francescodelucia/BabyCarCANBUS/Componenti_Codice_PCB/ControlloPWM_Motori/Senzanome.png

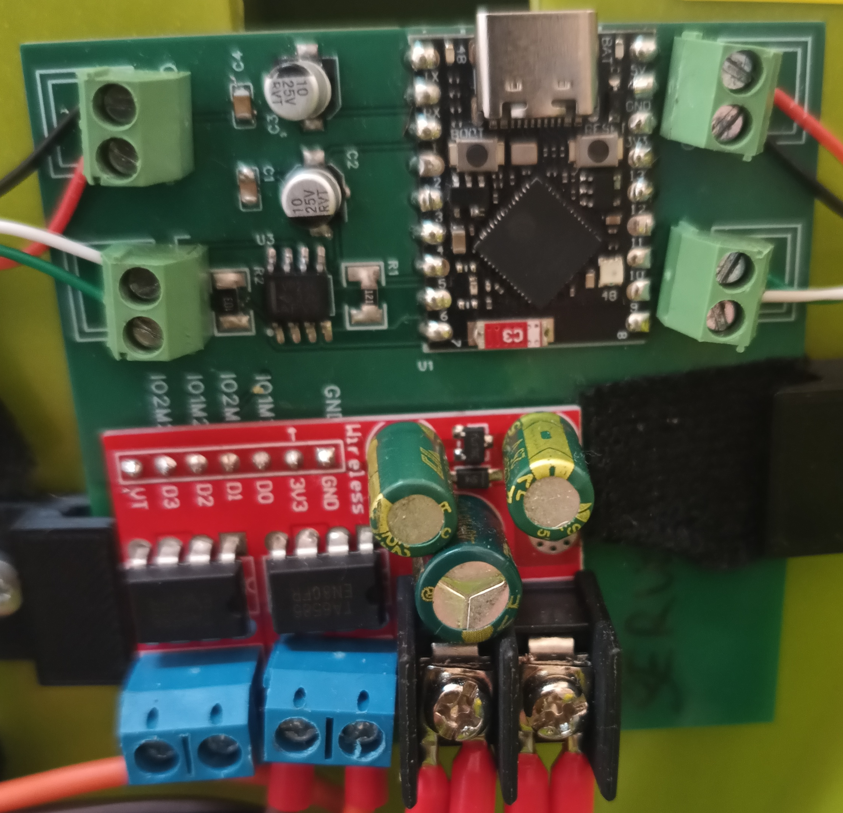
Componenti_Codice_PCB/ControlloPWM_Motori/Senzanome.png
