francescodelucia/BabyCarCANBUS/Componenti_Codice_PCB/ECU_dashboard_integrato/code/ECU_dashboard_integrato/imgs/dash_main.bmp

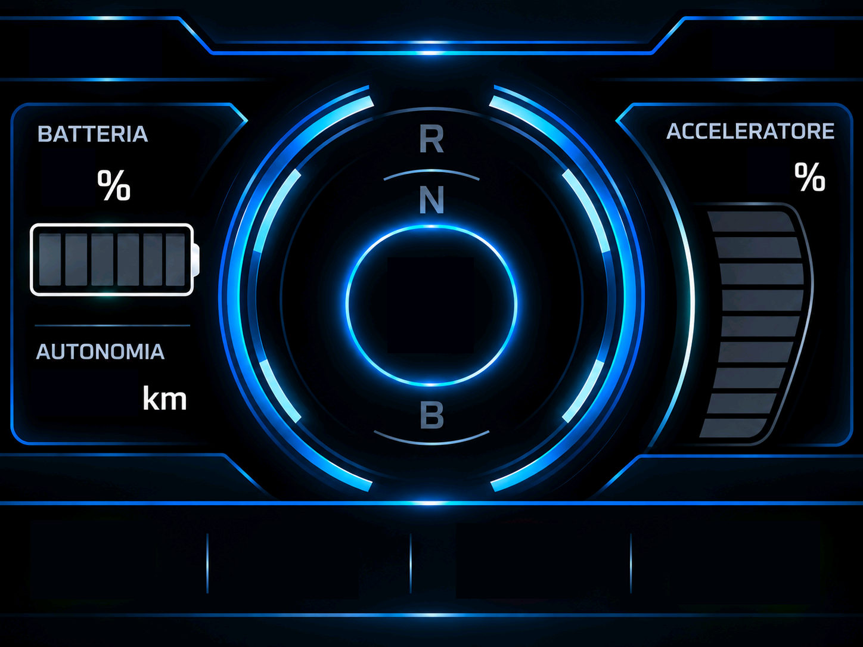
Componenti_Codice_PCB/ECU_dashboard_integrato/code/ECU_dashboard_integrato/imgs/dash_main.bmp
