francescodelucia/BabyCarCANBUS/Componenti_Codice_PCB/ECU_dashboard_integrato/code/ECU_dashboard_integrato/imgs/spia_carica.bmp

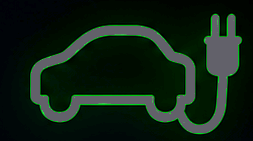
Componenti_Codice_PCB/ECU_dashboard_integrato/code/ECU_dashboard_integrato/imgs/spia_carica.bmp
