francescodelucia/BabyCarCANBUS/Componenti_Codice_PCB/ECU_dashboard_integrato/display.jpg

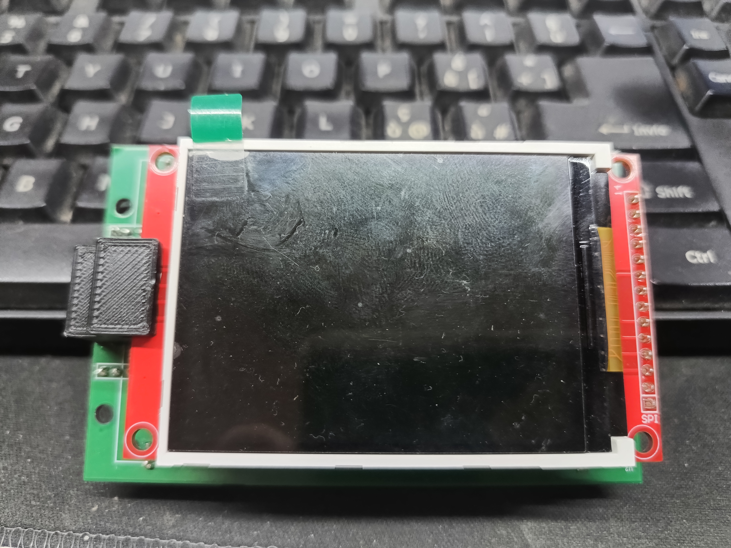
Componenti_Codice_PCB/ECU_dashboard_integrato/display.jpg
