francescodelucia/BabyCarCANBUS/Componenti_Codice_PCB/ECU_dashboard_integrato/display_on.jpg

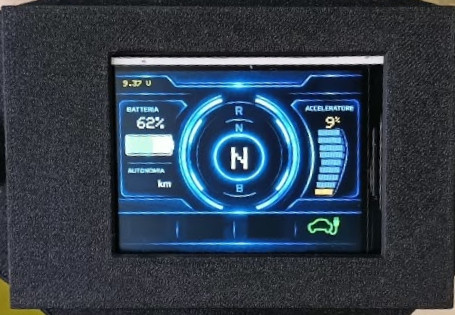
Componenti_Codice_PCB/ECU_dashboard_integrato/display_on.jpg
