francescodelucia/BabyCarCANBUS/Componenti_Codice_PCB/ECU_dashboard_integrato/pcb_button.png

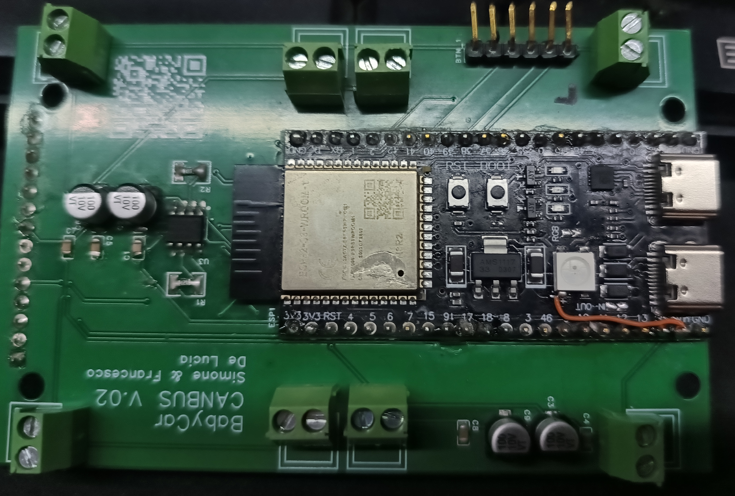
Componenti_Codice_PCB/ECU_dashboard_integrato/pcb_button.png
