francescodelucia/BabyCarCANBUS/Componenti_Codice_PCB/ECU_dashboard_integrato/pcb_top.jpg

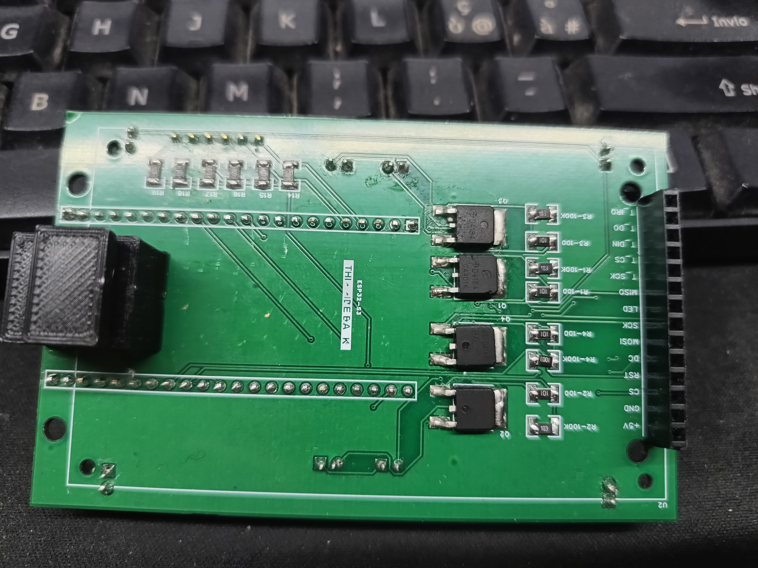
Componenti_Codice_PCB/ECU_dashboard_integrato/pcb_top.jpg
