francescodelucia/BabyCarCANBUS/Componenti_Codice_PCB/Sensore_Lidar/Senzanome.png

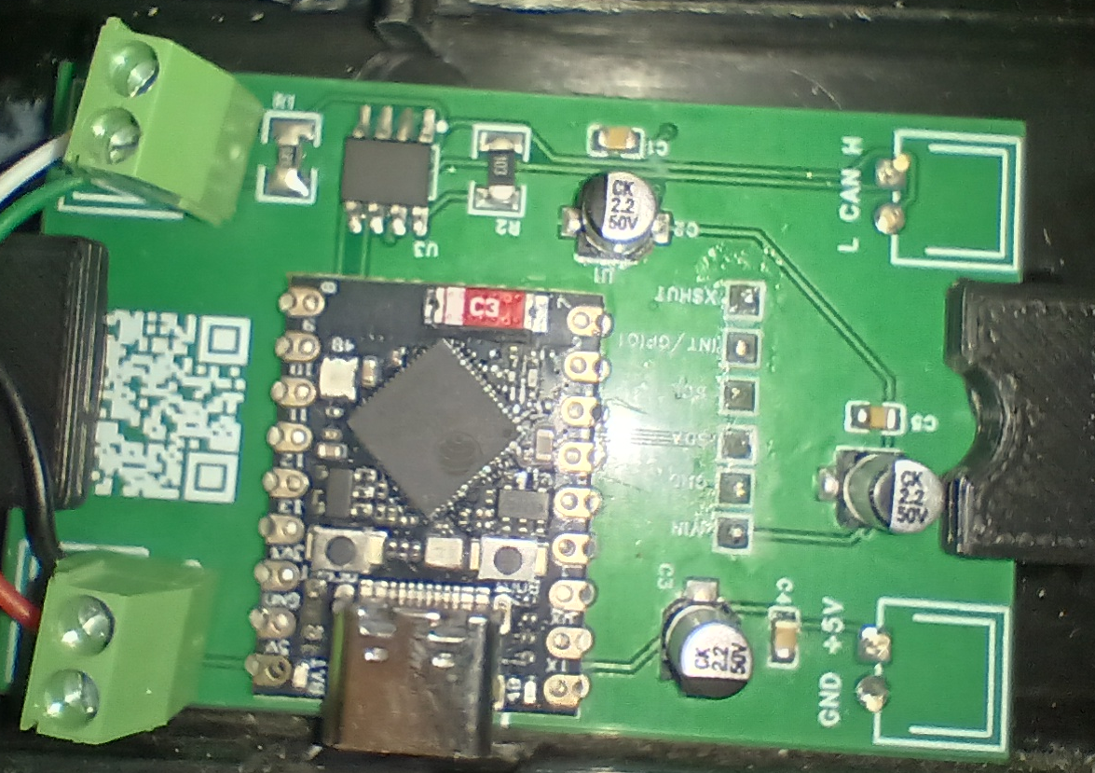
Componenti_Codice_PCB/Sensore_Lidar/Senzanome.png
