francescodelucia/BabyCarCANBUS/pcbs/Anti_Colision_Lidar/3D_BabyCar_CANBUS_Lidar.png

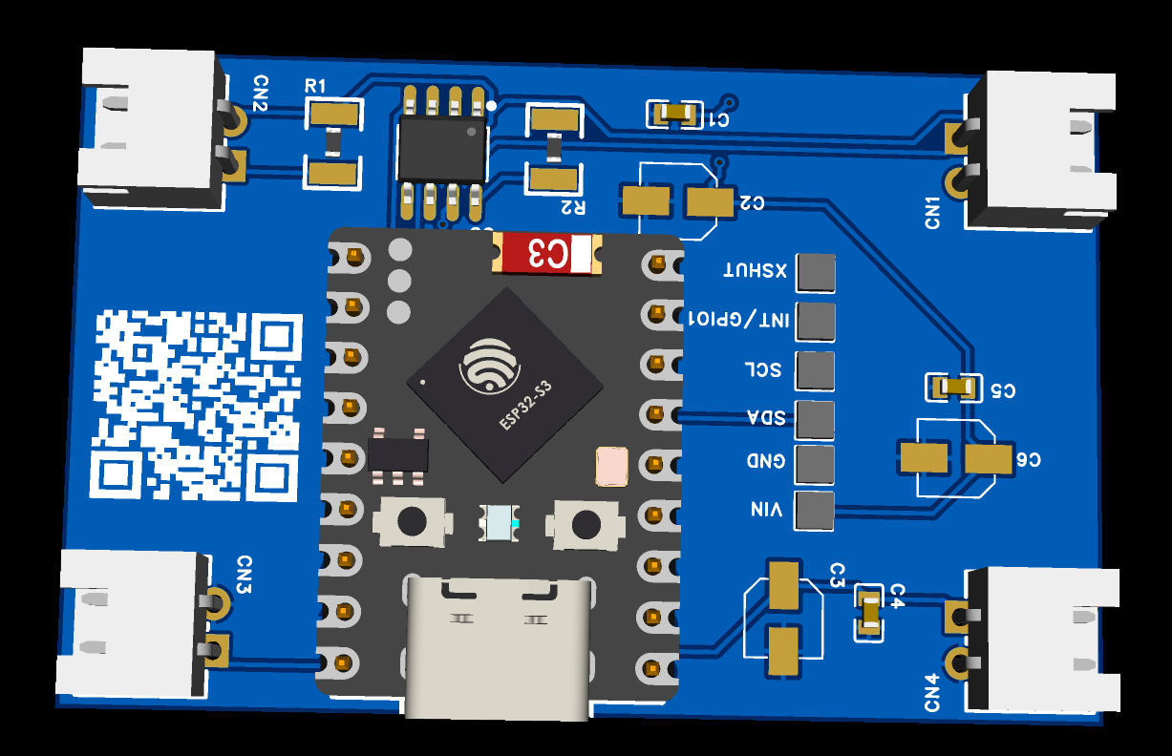
pcbs/Anti_Colision_Lidar/3D_BabyCar_CANBUS_Lidar.png
