francescodelucia/BabyCarCANBUS/pcbs/Anti_Colision_Lidar/PCB_BabyCAR_CANBUS_Lidar.png

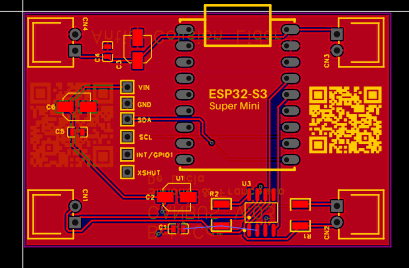
pcbs/Anti_Colision_Lidar/PCB_BabyCAR_CANBUS_Lidar.png
