francescodelucia/BabyCarCANBUS/pcbs/ECU_display_data_info/3d.png

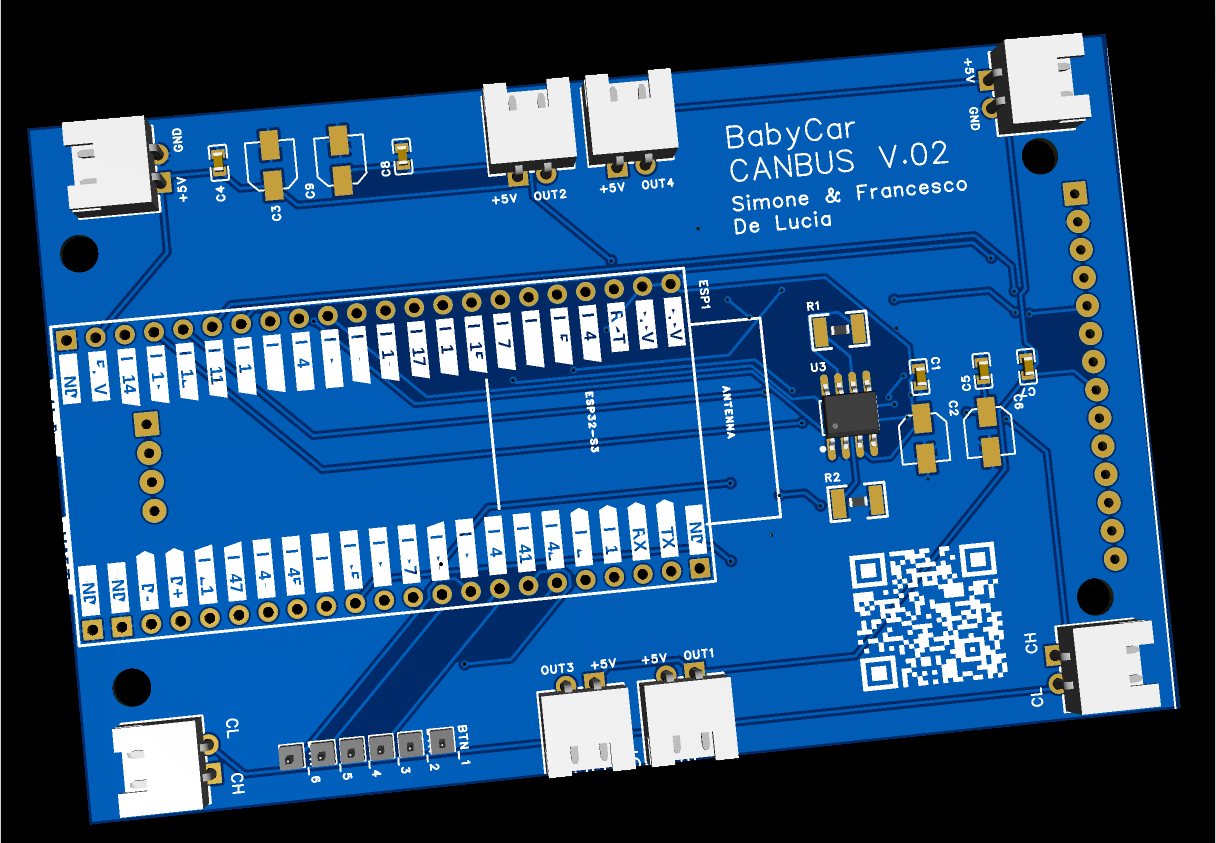
pcbs/ECU_display_data_info/3d.png
