francescodelucia/BabyCarCANBUS/pcbs/ECU_display_data_info/back_pcb.png

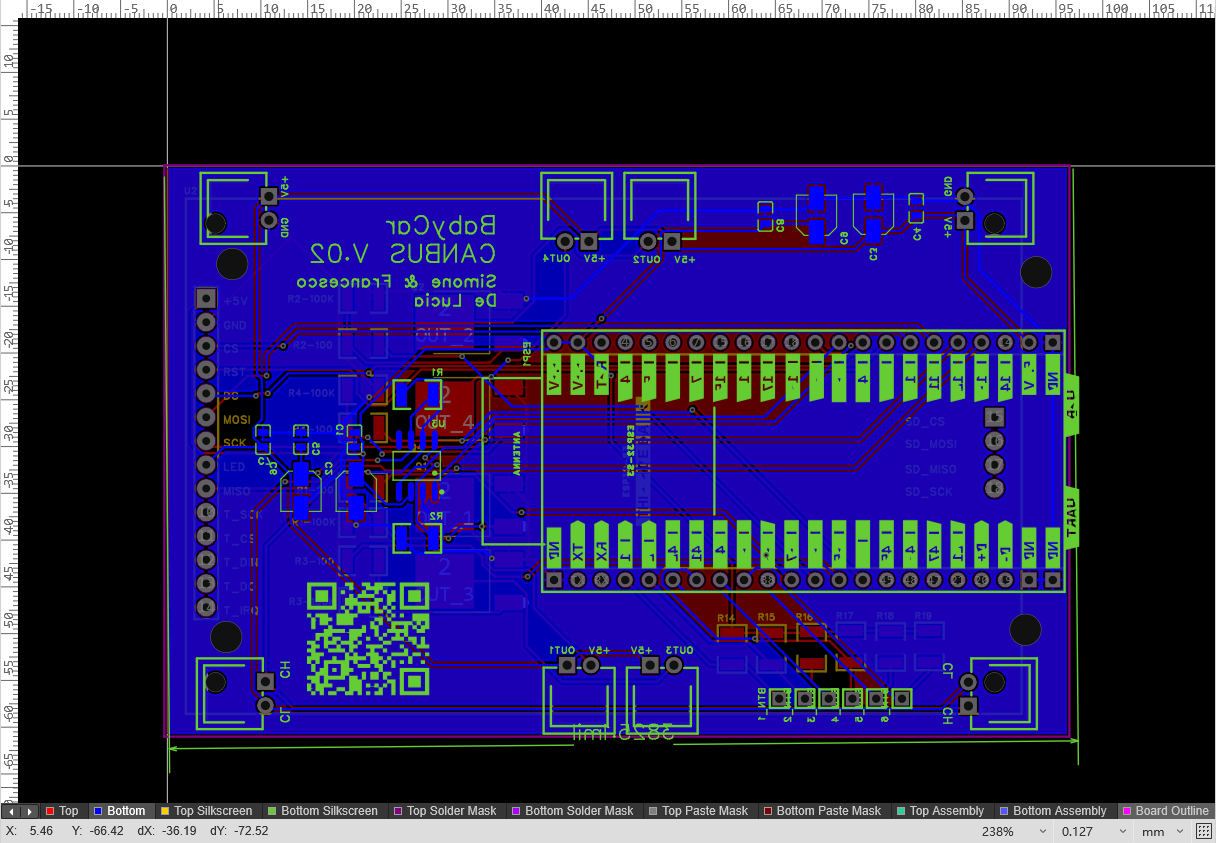
pcbs/ECU_display_data_info/back_pcb.png
