francescodelucia/BabyCarCANBUS/pcbs/ECU_display_data_info/front_pcb.png

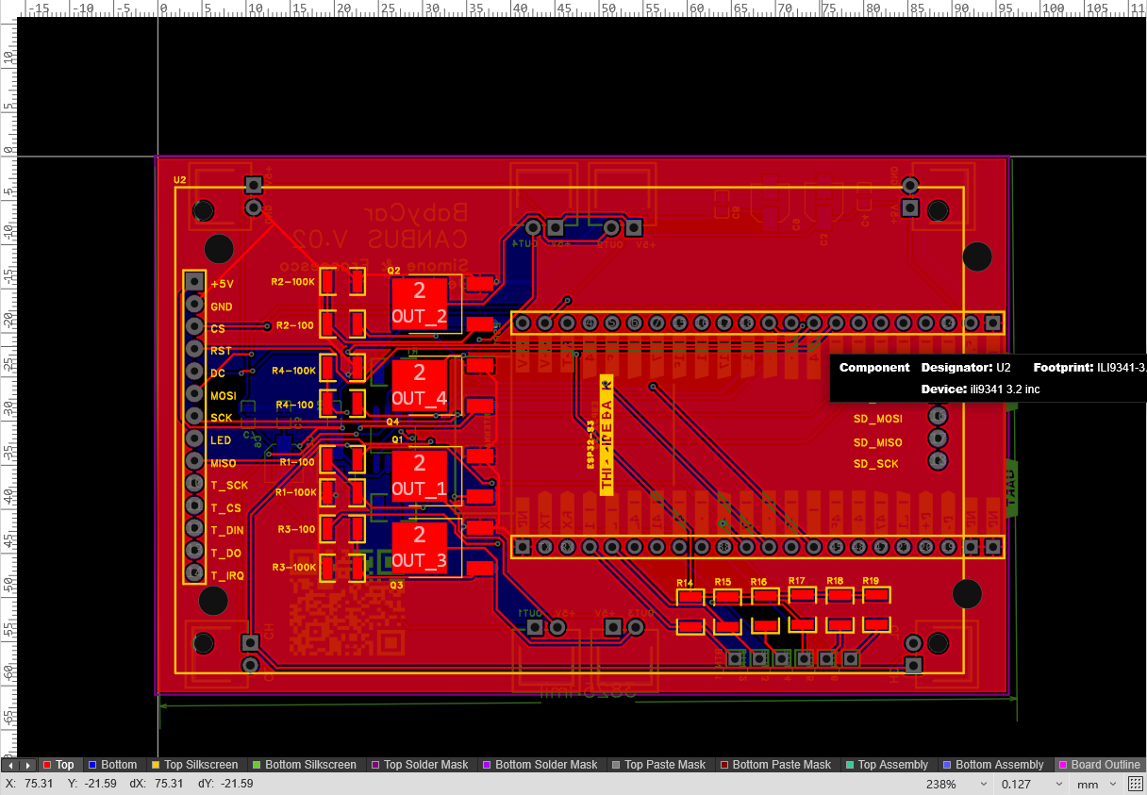
pcbs/ECU_display_data_info/front_pcb.png
