francescodelucia/BabyCarCANBUS/pcbs/Light_Battery_Control/scheda_contollo_accelleratore_3D.png

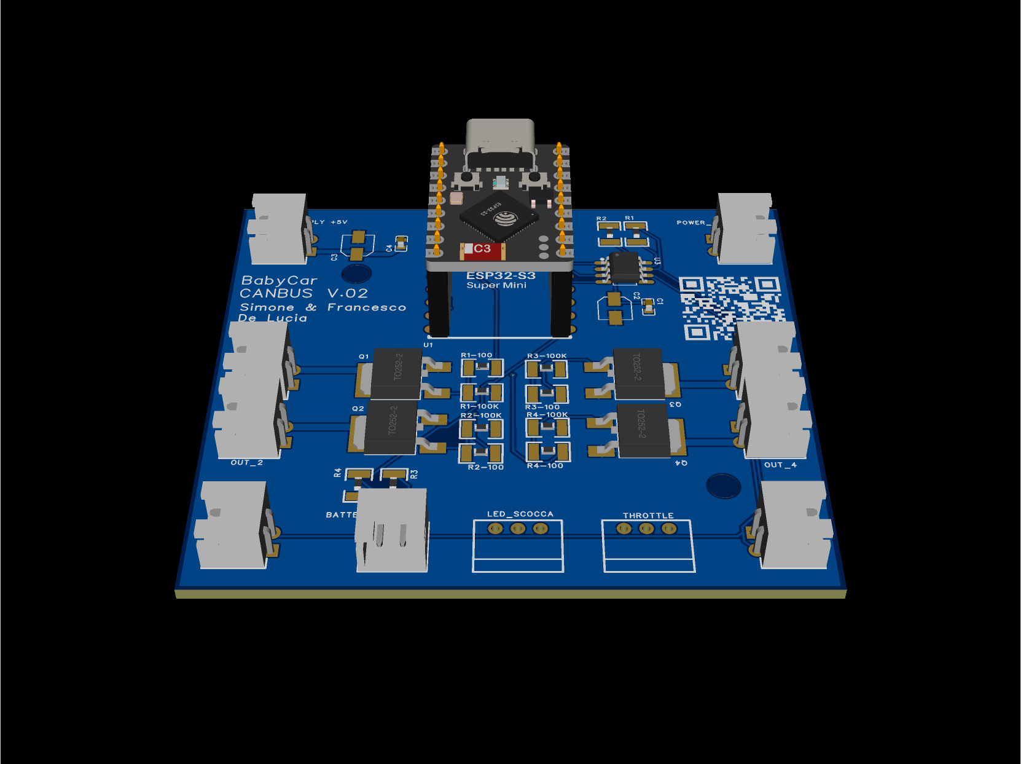
pcbs/Light_Battery_Control/scheda_contollo_accelleratore_3D.png
