francescodelucia/BabyCarCANBUS/pcbs/Light_Battery_Control/scheda_contollo_accelleratore_pcb.png

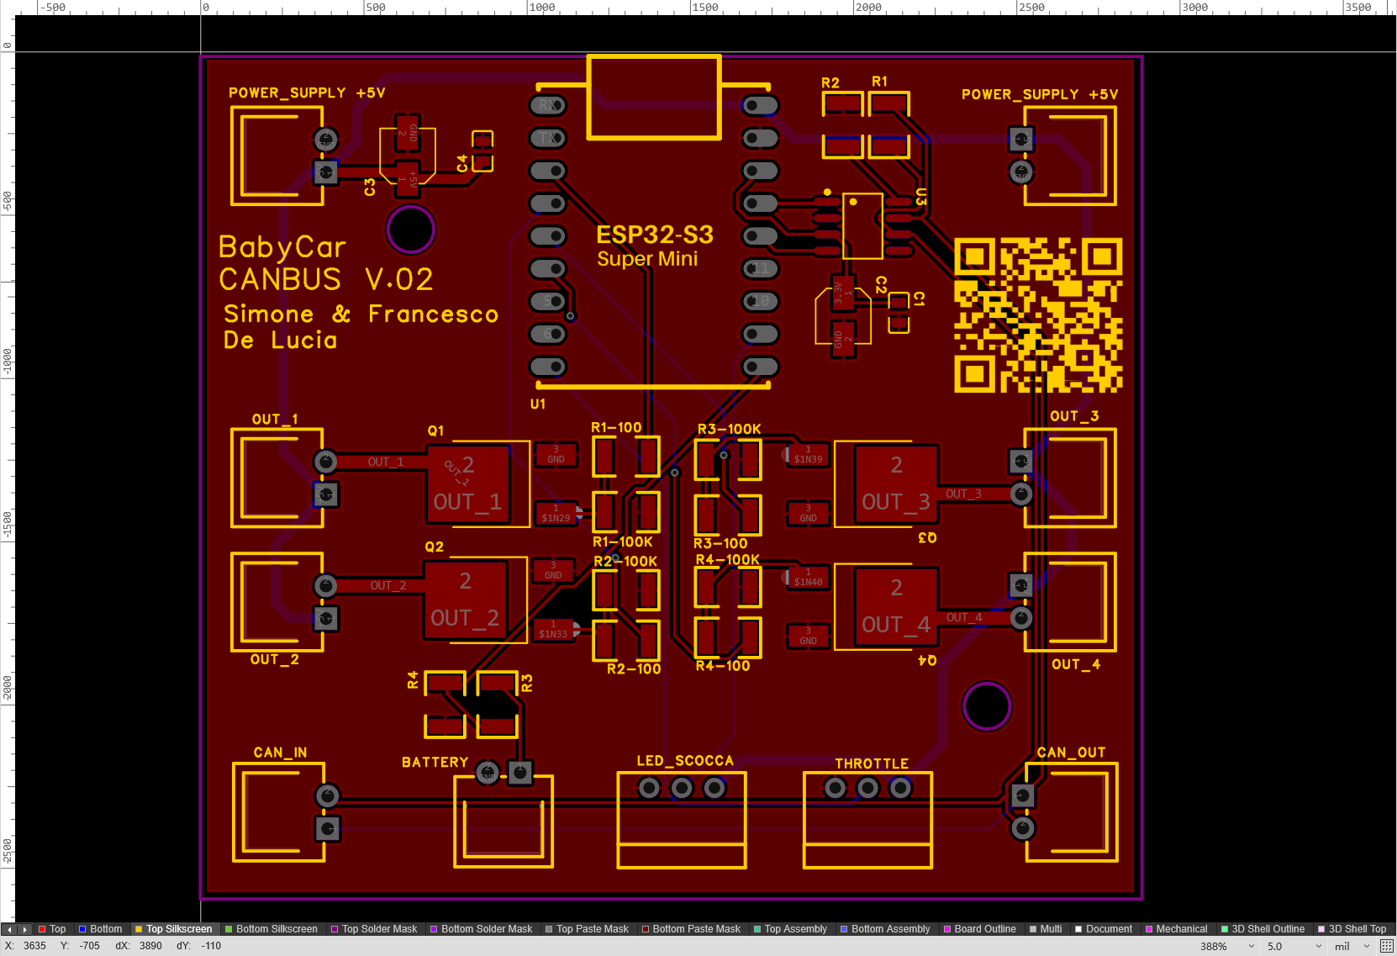
pcbs/Light_Battery_Control/scheda_contollo_accelleratore_pcb.png
