francescodelucia/BabyCarCANBUS/pcbs/Light_Battery_Control/scheda_contollo_accelleratore_schemaelettrico.png

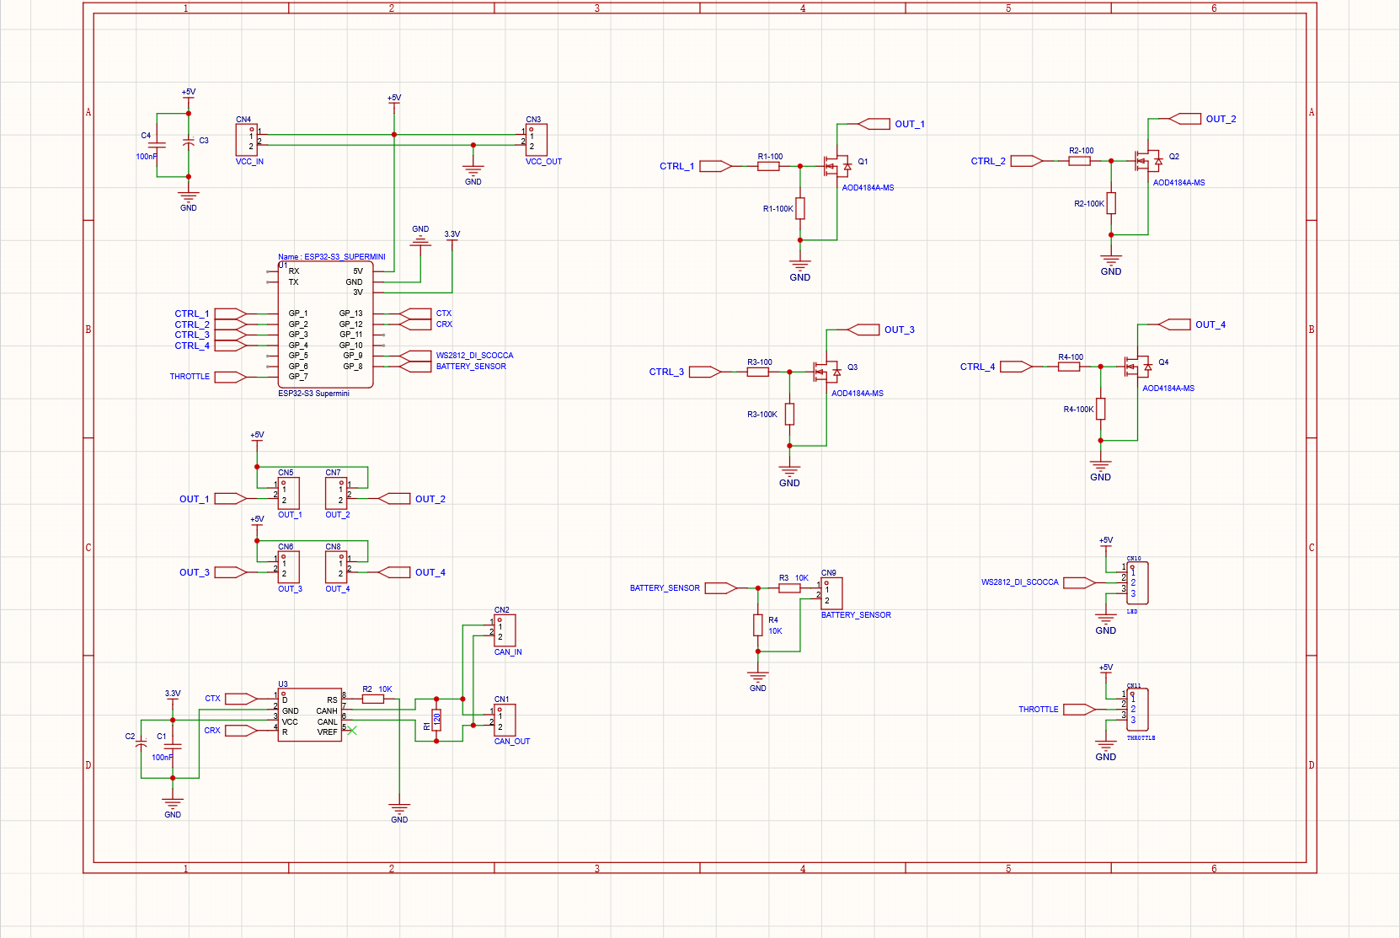
pcbs/Light_Battery_Control/scheda_contollo_accelleratore_schemaelettrico.png
