francescodelucia/BabyCarCANBUS/V1_images/2jpeg.jpeg

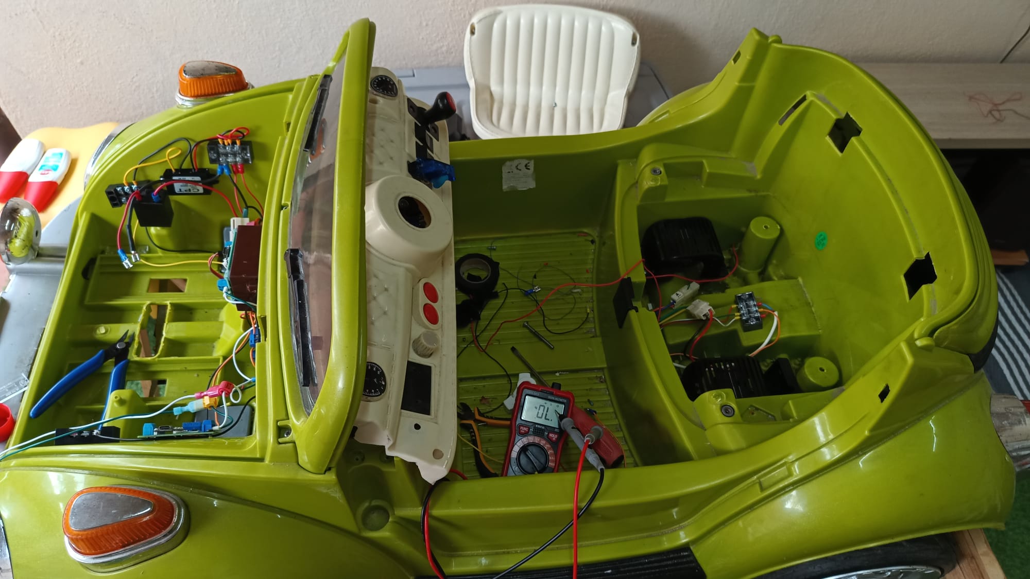
V1_images/2jpeg.jpeg
