francescodelucia/BabyCarCANBUS/V1_images/4.jpeg

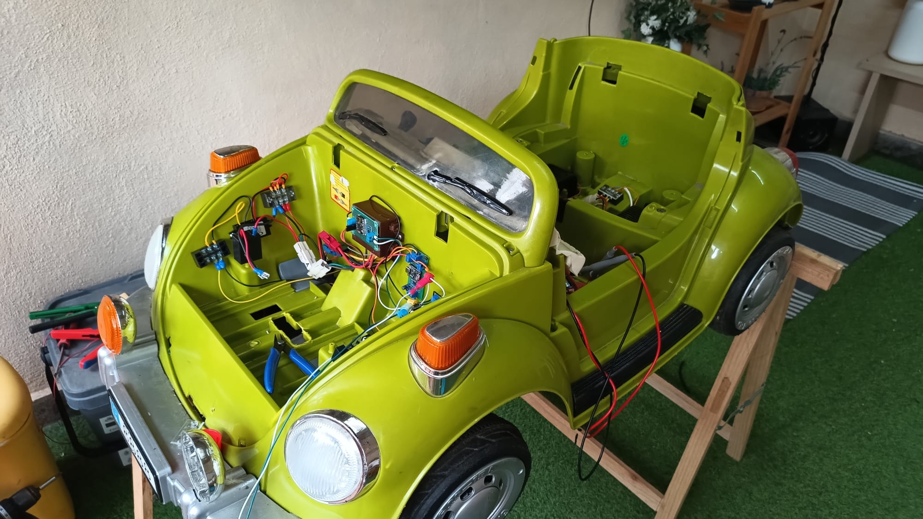
V1_images/4.jpeg
