francescodelucia/BabyCarCANBUS/V1_images/5.jpeg

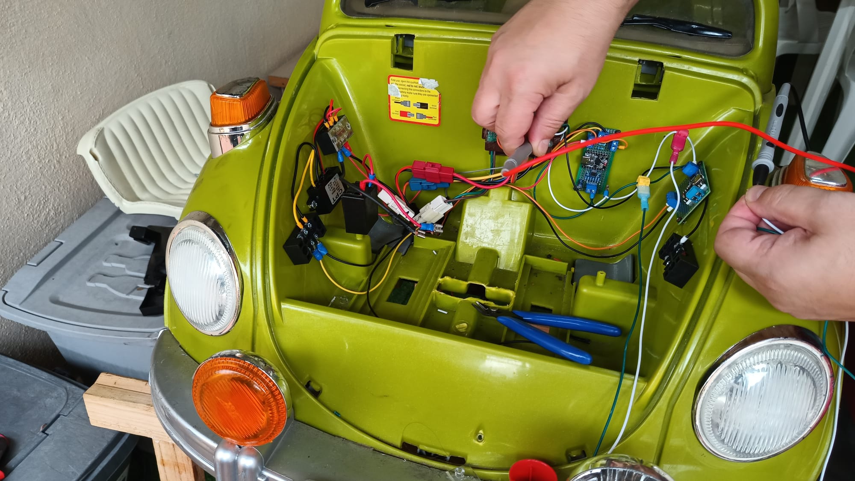
V1_images/5.jpeg
