francescodelucia/BabyCarCANBUS/V1_images/6.jpeg

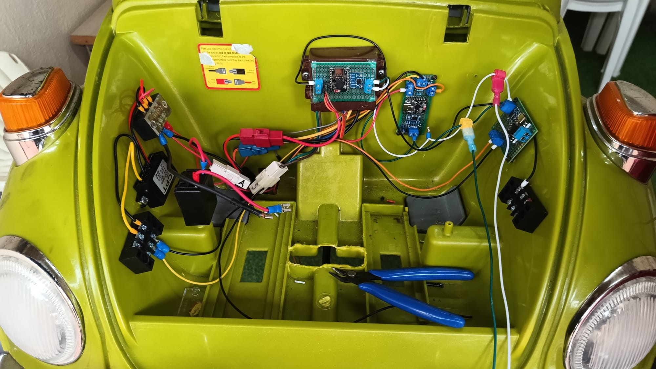
V1_images/6.jpeg
