francescodelucia/BabyCarCANBUS/V1_images/10.jpeg

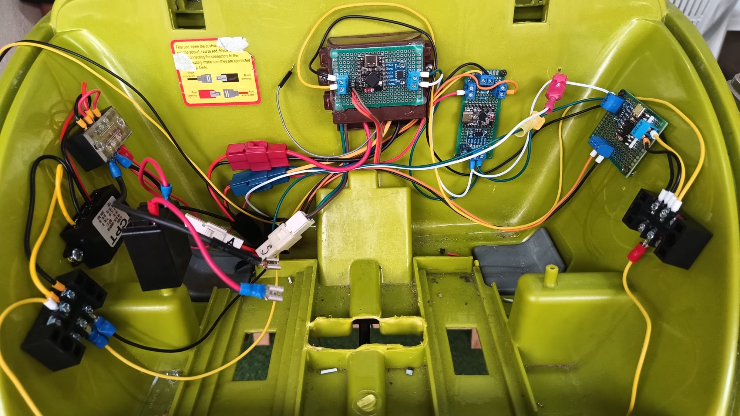
V1_images/10.jpeg
