francescodelucia/BabyCarCANBUS/V1_images/11.jpeg

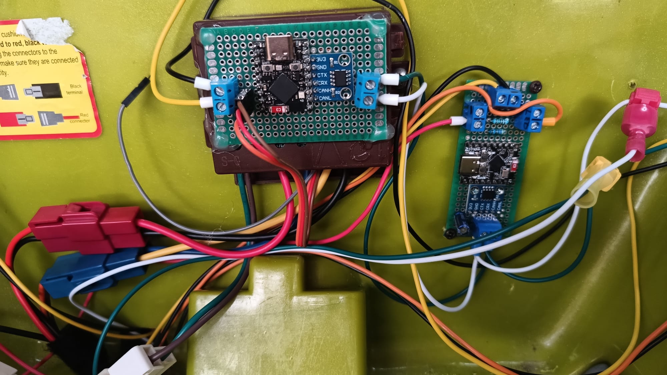
V1_images/11.jpeg
