francescodelucia/BabyCarCANBUS/V1_images/12.jpeg

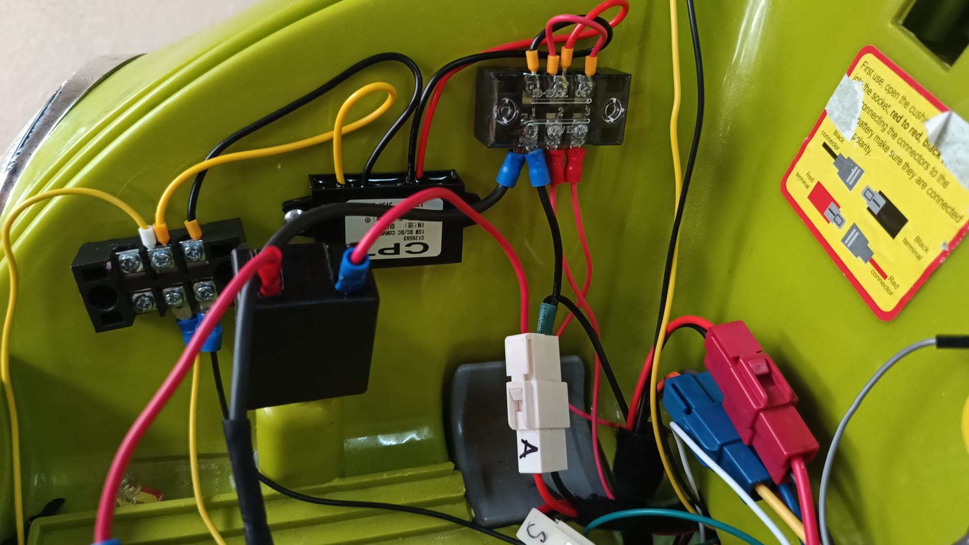
V1_images/12.jpeg
