francescodelucia/BabyCarCANBUS/V1_images/17.jpeg

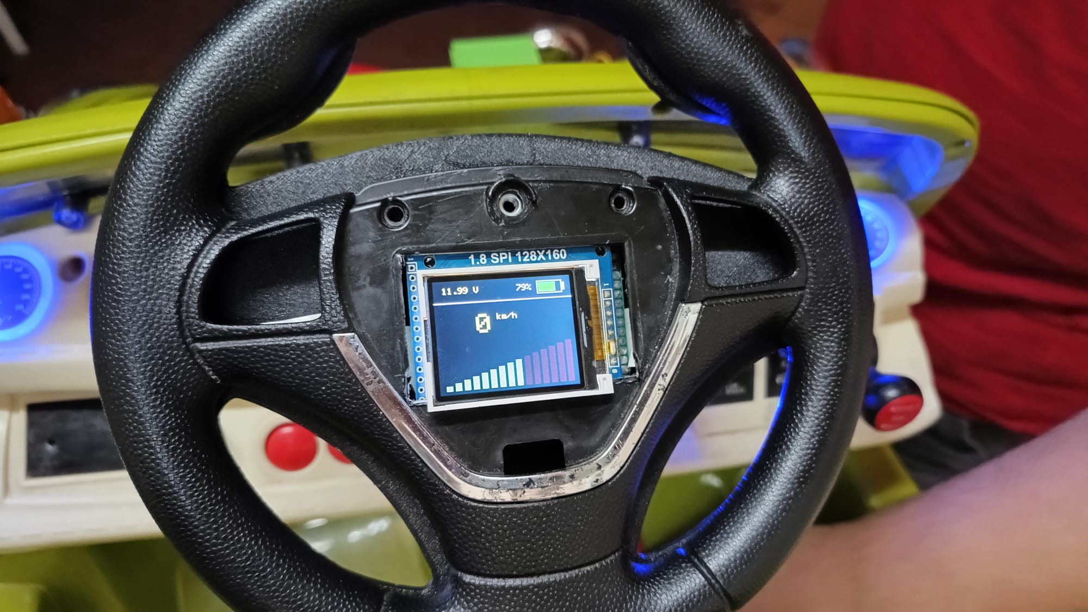
V1_images/17.jpeg
