francescodelucia/BabyCarCANBUS/V1_images/18.jpeg

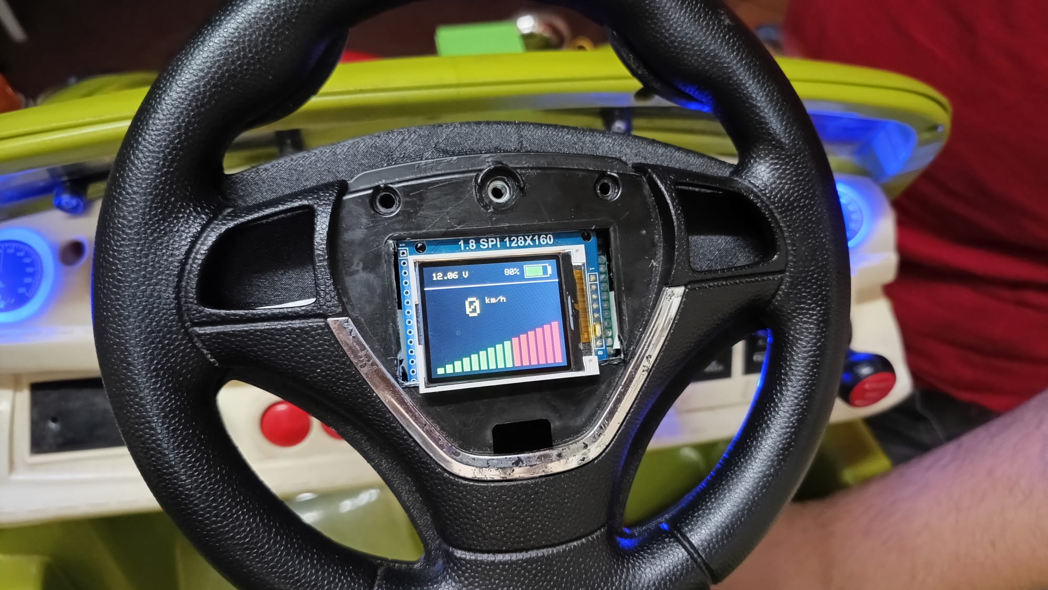
V1_images/18.jpeg
