francescodelucia/BabyCarCANBUS/V1_images/21.jpeg

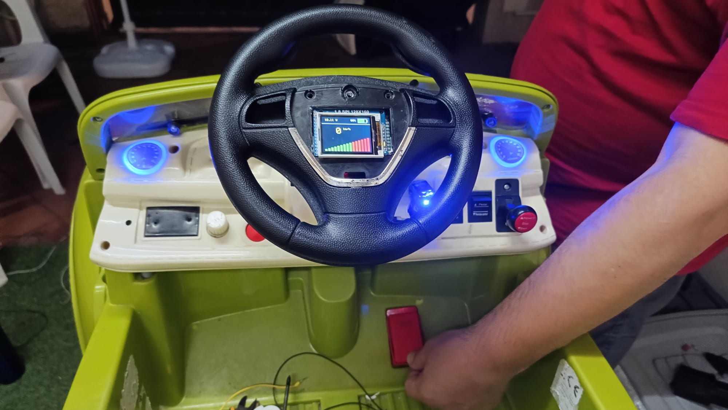
V1_images/21.jpeg
