francescodelucia/BabyCarCANBUS/3d/EncoderManubrio.FCStd

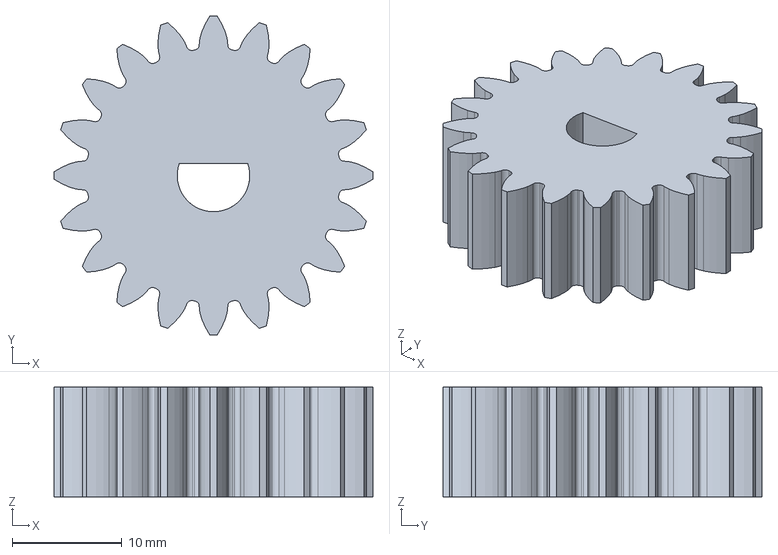
[picture p31: CAD file, 2026-10-26]
3d/EncoderManubrio.FCStd
29.0 x 29.0 x 10.0 mm
