francescodelucia/BabyCarCANBUS/3d/Supporti_per_schede.FCStd

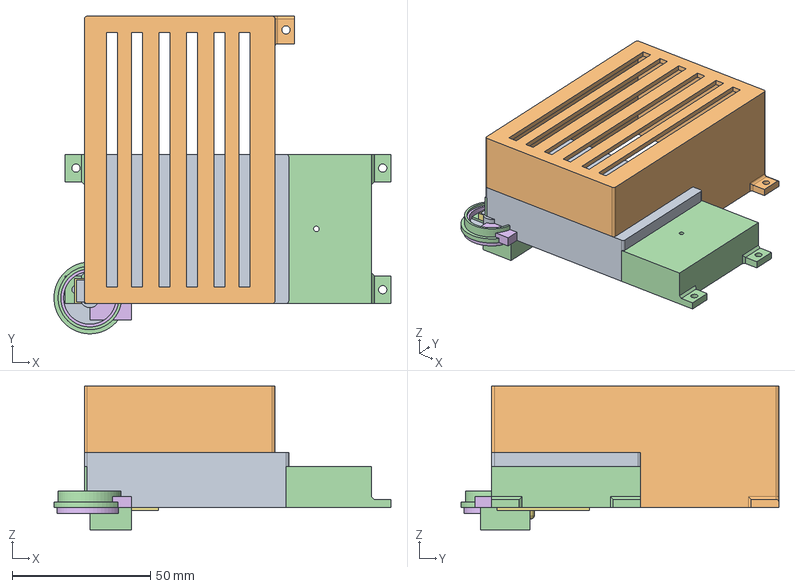
[picture p32: CAD file, 2026-10-26]
3d/Supporti_per_schede.FCStd
122.0 x 115.0 x 52.0 mm
Supporto_PCB_extern
Supporto
Supporto_PCB
Scocca
Tappo
Supporto_alto
manubrio_fake
SactolaPerFili
SactolaTrasformatore
TappoRettangolare
TappoPerMolla
Pulsante
TappoRotondo_piatto
TappoLungoCircolare
TappoFungo
TappoLungoRettangolare
