francescodelucia/BabyCarCANBUS/3d/Manubrio.FCStd

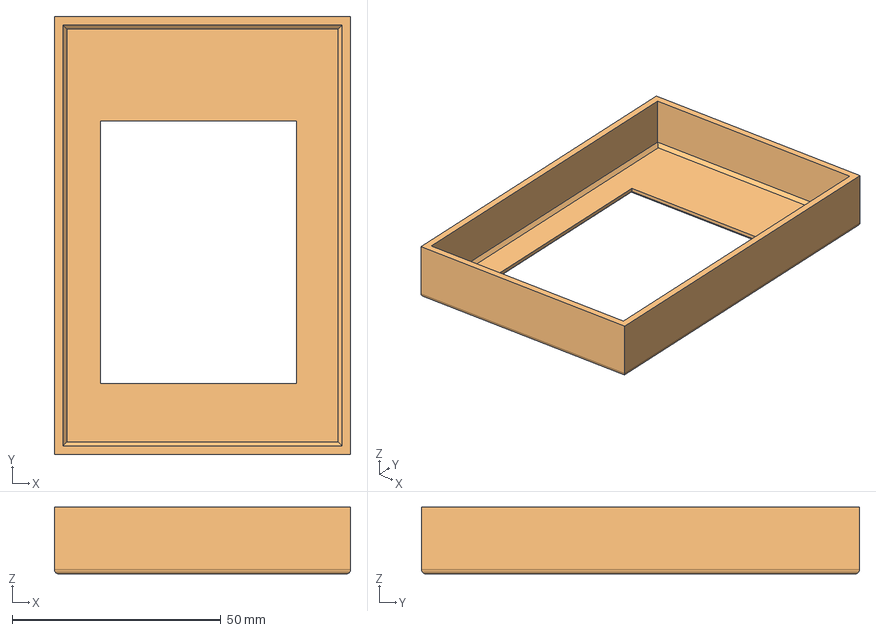
[picture p33: CAD file, 2026-10-26]
3d/Manubrio.FCStd
71.0 x 105.0 x 16.0 mm
MascherinaDisplay
