francescodelucia/BabyCarCANBUS/3d/Scatole_Centaline.FCStd

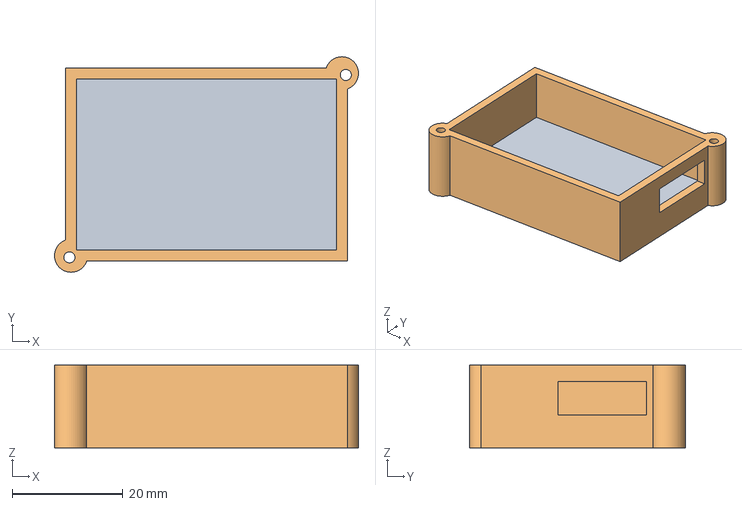
[picture p34: CAD file, 2026-10-26]
3d/Scatole_Centaline.FCStd
55.0 x 39.0 x 15.0 mm
Coperchio
Contenitore
