francescodelucia/BabyCarCANBUS/3d/steering wheel_part3.stl

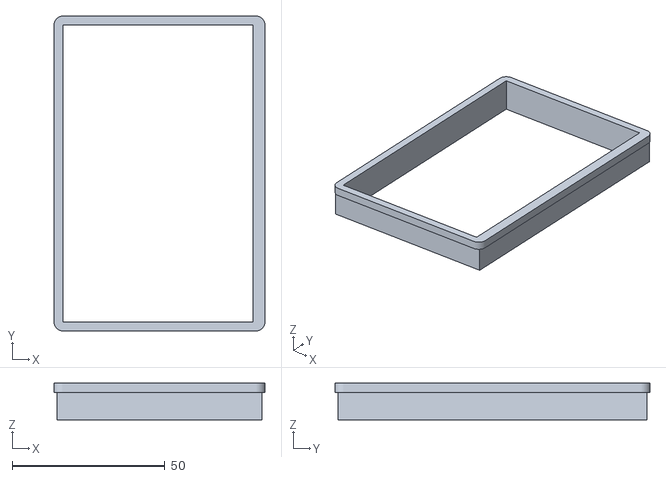
[picture p35: CAD file, 2026-08-19]
3d/steering wheel_part3.stl
69.0 x 103.0 x 12.0
