francescodelucia/BabyCarCANBUS/3d/steering wheel_part5.stl

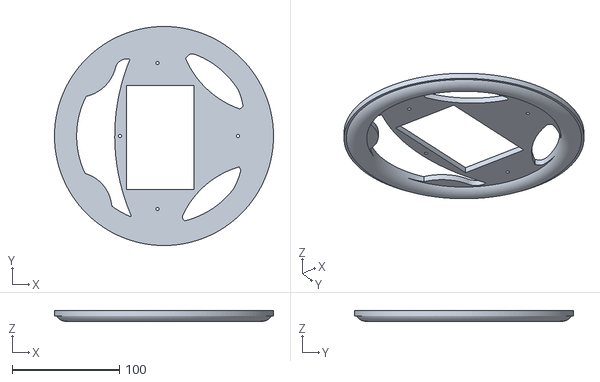
[picture p36: CAD file, 2026-08-19]
3d/steering wheel_part5.stl
204.4 x 204.4 x 10.0
