francescodelucia/BabyCarCANBUS/3d/steering wheel_part2.stl

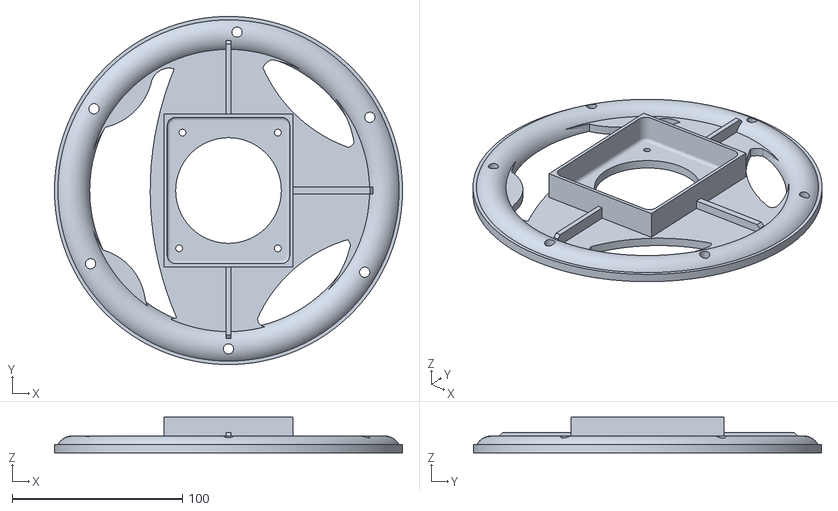
[picture p37: CAD file, 2026-08-19]
3d/steering wheel_part2.stl
204.4 x 204.4 x 21.0
