francescodelucia/BabyCarCANBUS/3d/steering wheel_part4.stl

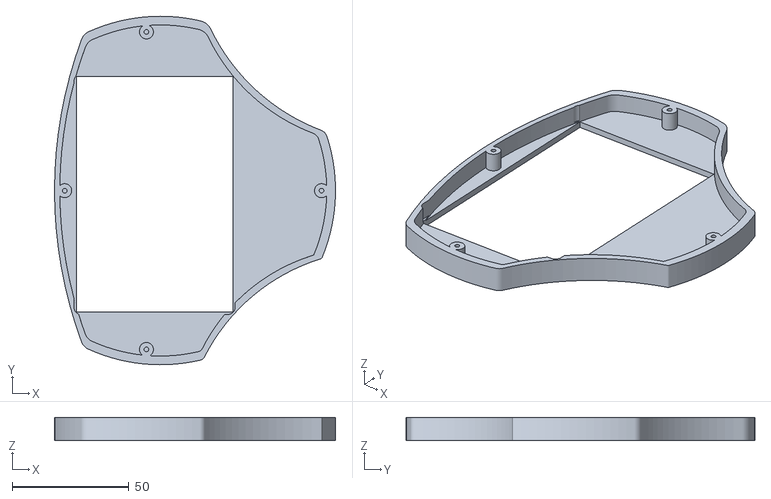
[picture p38: CAD file, 2026-08-19]
3d/steering wheel_part4.stl
120.4 x 149.3 x 10.0
