francescodelucia/BabyCarCANBUS/3d/steering wheel_part1.stl

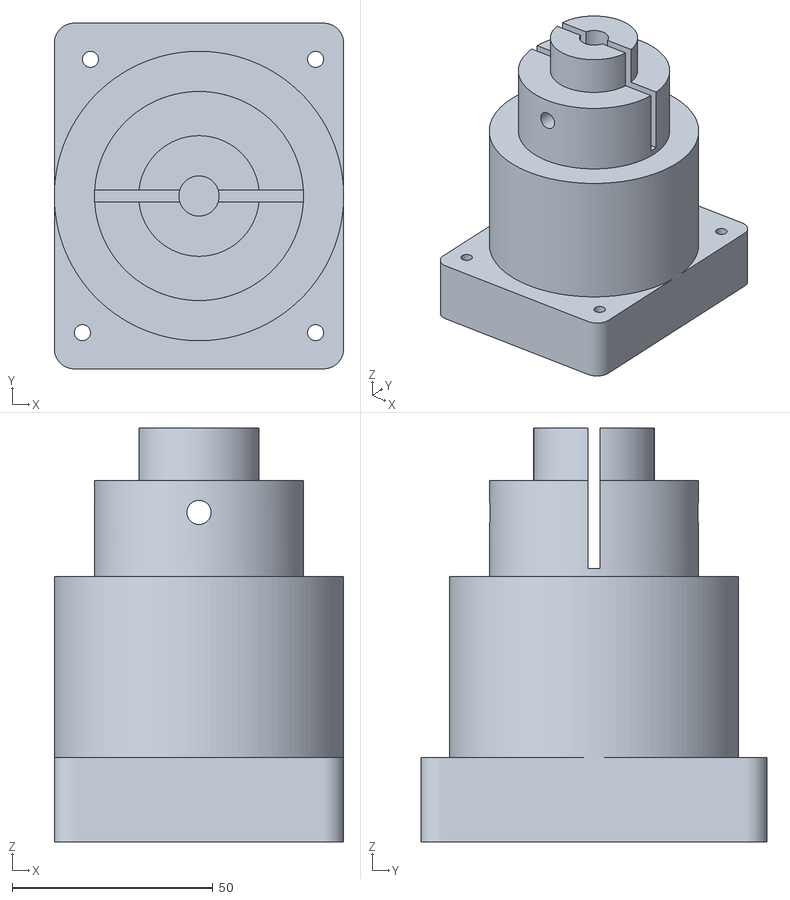
[picture p39: CAD file, 2026-08-19]
3d/steering wheel_part1.stl
72.0 x 86.0 x 103.0
