francescodelucia/BabyCarCANBUS/3d/steering wheel.stl

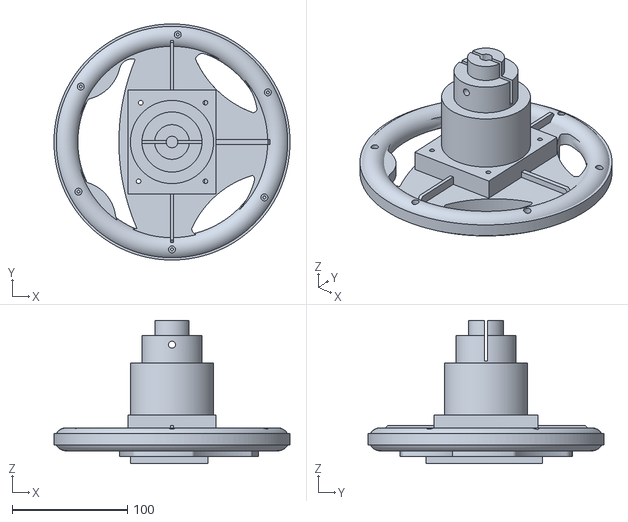
[picture p40: CAD file, 2026-08-19]
3d/steering wheel.stl
204.4 x 204.4 x 124.0
