francescodelucia/BabyCarCANBUS/Componenti_Codice_PCB/Acceleratore_CelladiCarico/SCH_Schematic4_2026-10-22.pdf

### GND GND

### OUT_2 OUT_1

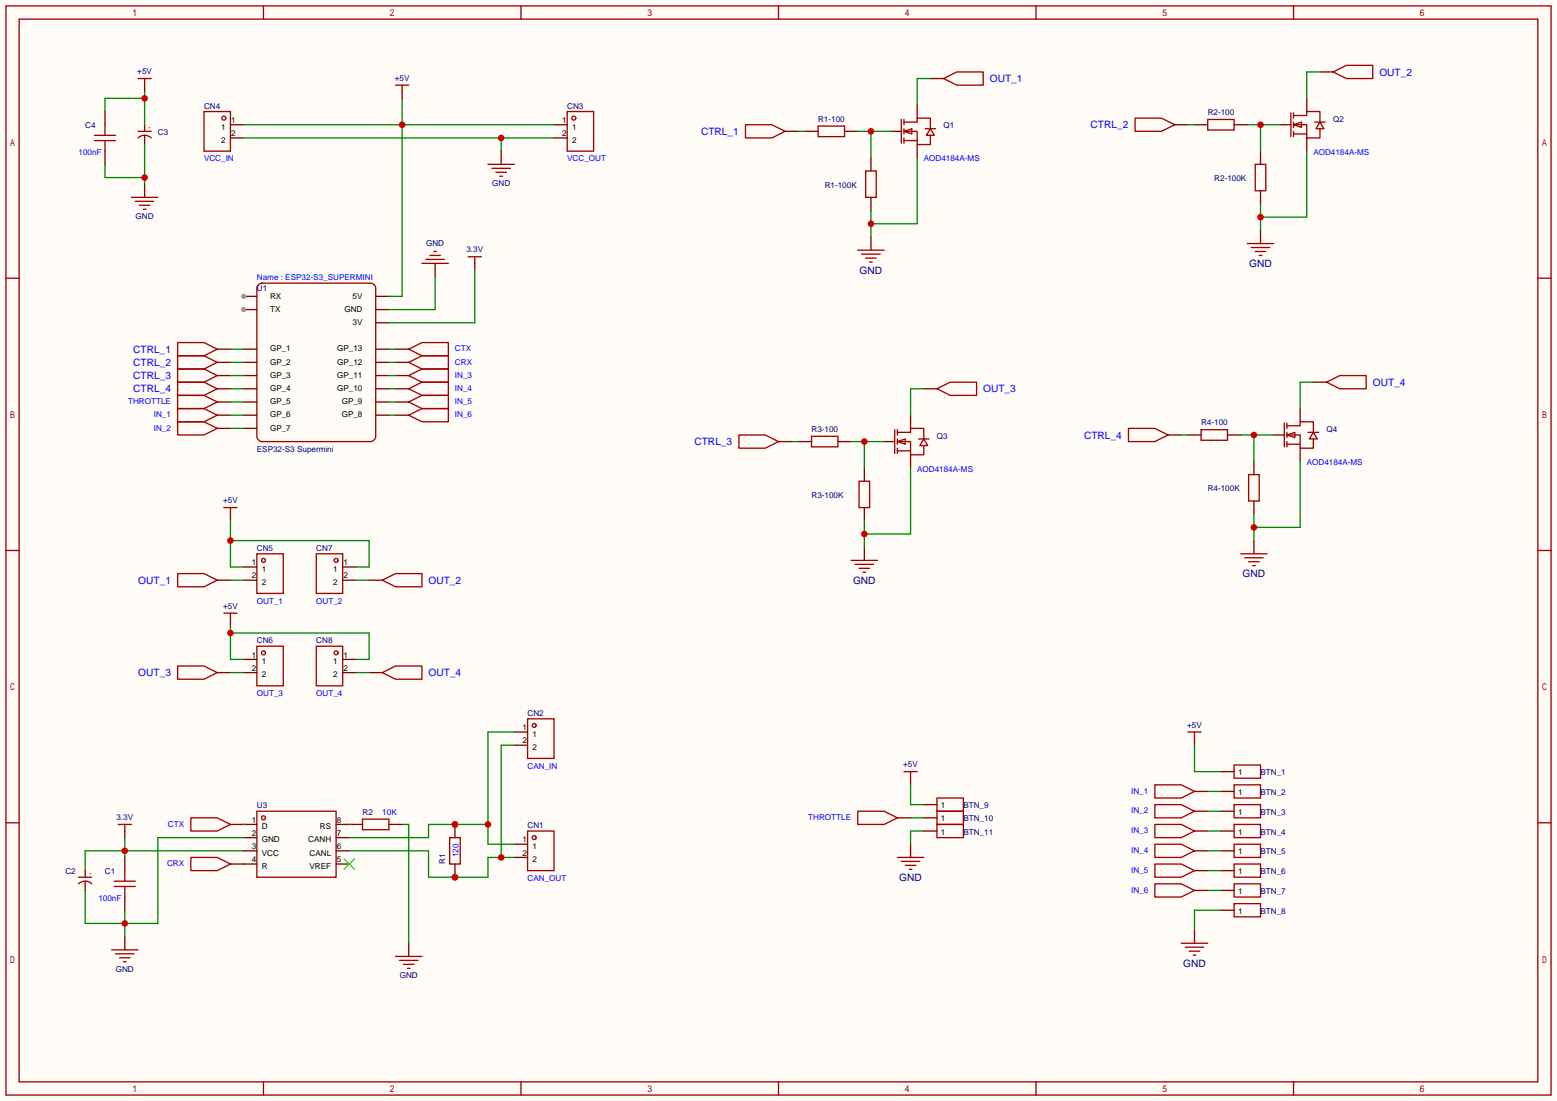
[picture p41: page 1]
