francescodelucia/BabyCarCANBUS/Componenti_Codice_PCB/ControlloPWM_Motori/SCH_Schematic5_2026-10-22.pdf

### GND

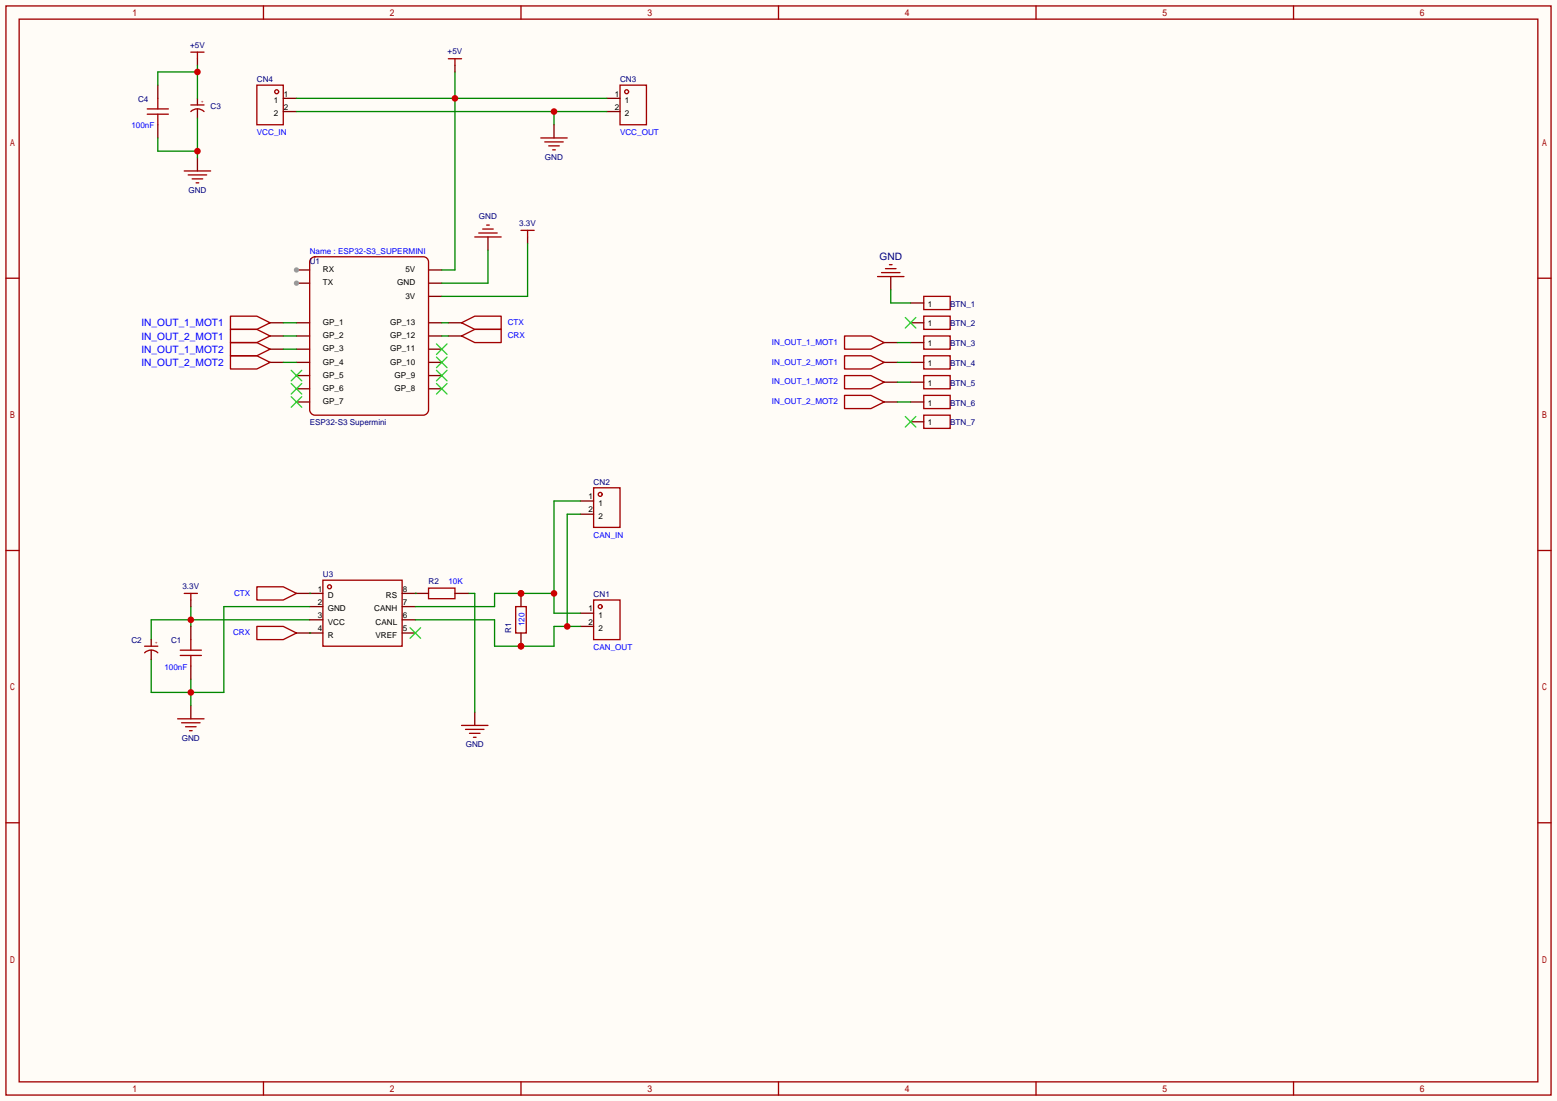
[picture p42: page 1]
