francescodelucia/BabyCarCANBUS/pcbs/Light_Battery_Control/pcb_BOM.pdf

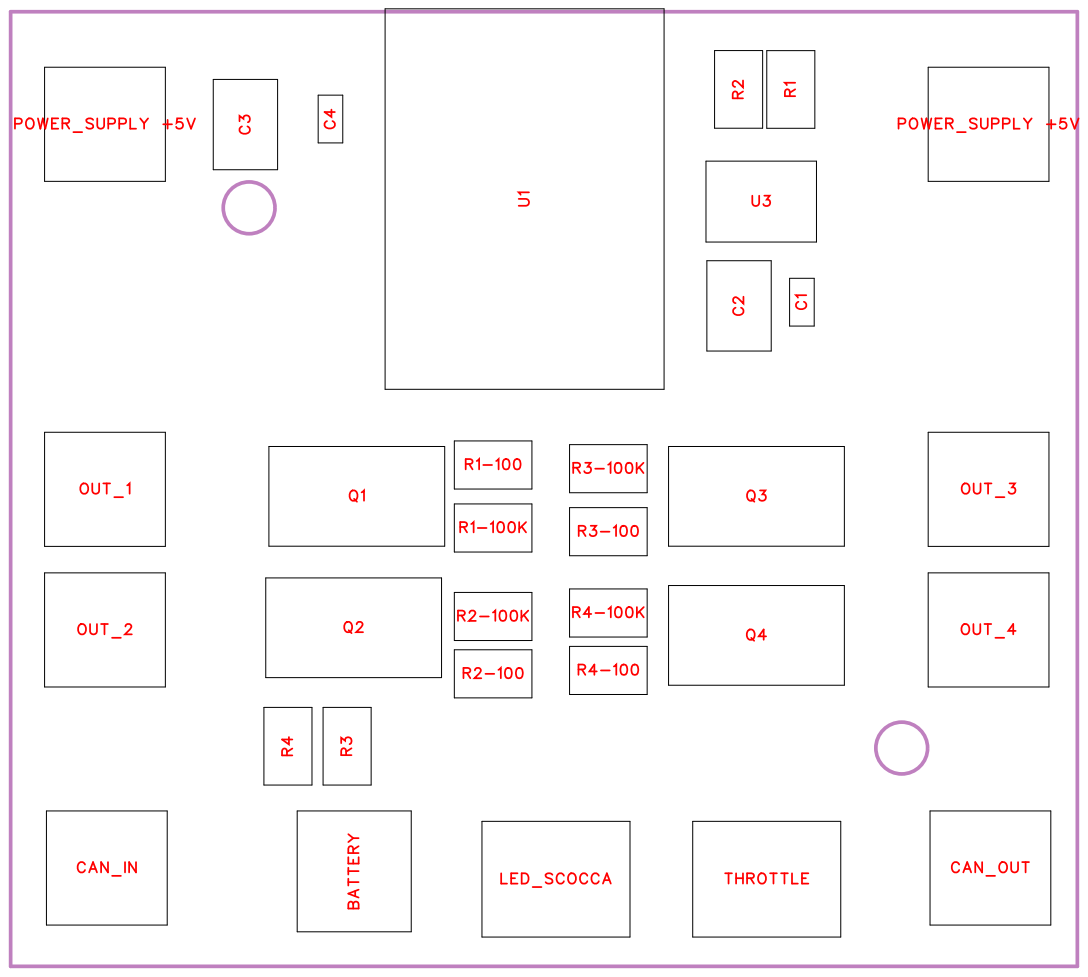
[picture p43: page 1]

No. | Quantity | Comment | Designator | Footprint | Value | Manufacturer Part | Manufacturer | Supplier Part | Supplier
1 | 1 | BATTERY_S ENSOR | BATTERY | CONN-TH_2 P-P2.54_SIP 2-2.54L | | BATTERY_S ENSOR | | C990001953 7 | LCSC
2 | 2 | 100nF | C1,C4 | CAP-SMD_L 1.8-W1.0_G RMJN | 100nF
3 | 2 | e-radionica.c om schemati cs_ELECTR OLITIC_CAP _4mm | C2,C3 | e-radionica.c om footprinti: ELECTROLI TIC_CAP_4 mm | EDK106M01 6A9BAA
4 | 1 | CAN_IN | CAN_IN | CONN-TH_2 P-P2.54_SIP 2-2.54L | | CAN_IN | | C990001953 7 | LCSC
5 | 1 | CAN_OUT | CAN_OUT | CONN-TH_2 P-P2.54_SIP 2-2.54L | | CAN_OUT | | C990001953 7 | LCSC
6 | 1 | LED | LED_SCOCCA | COMM-TH_3 P-P2.54_DC-DC-5V | | SIP5-2.54m m | null | C990000905 3 | LCSC
7 | 1 | OUT_1 | OUT_1 | CONN-TH_2 P-P2.54_SIP 2-2.54L | | OUT_1 | | C990001953 7 | LCSC
8 | 1 | OUT_2 | OUT_2 | CONN-TH_2 P-P2.54_SIP 2-2.54L | | OUT_2 | | C990001953 7 | LCSC
9 | 1 | OUT_3 | OUT_3 | CONN-TH_2 P-P2.54_SIP 2-2.54L | | OUT_3 | | C990001953 7 | LCSC
10 | 1 | OUT_4 | OUT_4 | CONN-TH_2 P-P2.54_SIP 2-2.54L | | OUT_4 | | C990001953 7 | LCSC
11 | 1 | VCC_IN | POWER_SUPPLY +5V | CONN-TH_2 P-P2.54_SIP 2-2.54L | | VCC_IN | | C990001953 7 | LCSC
12 | 1 | VCC_OUT | POWER_SUPPLY +5V | CONN-TH_2 P-P2.54_SIP 2-2.54L | | VCC_OUT | | C990001953 7 | LCSC
13 | 4 | AOD4184A-MS | Q1,Q2,Q3,Q4 | TO-252-2_L6 .6-W6.1-P4.5 7-LS9.9-BR-CW | | AOD4184A-MS | MSKSEMI(美 森科) | C22462610 | LCSC
14 | 1 | 120 | R1 | R1206-1 | 120
15 | 5 | 100K | R1-100,R1-100K,R2-100K, R3-100K,R4-100K | R1206-1 | 100K
16 | 3 | 10K | R2,R3,R4 | R1206-1 | 10K
17 | 3 | 100 | R2-100,R3-100,R4-100 | R1206-1 | 100

18 | 1 | THROTTLE | THROTTLE | COMM-TH_3 P-P2.54_DC-DC-5V | SIP5-2.54m m | null | C990000905 3 | LCSC
19 | 1 | ESP32-S3_S UPERMINI | U1 | ESP32-S3_S UPERMINI
20 | 1 | SN65HVD23 0DR | U3 | SOIC-8_L4.9 -W3.9-P1.27-LS6.0-BL | SN65HVD23 0DR | TI(德州仪器 ) | C12084 | LCSC

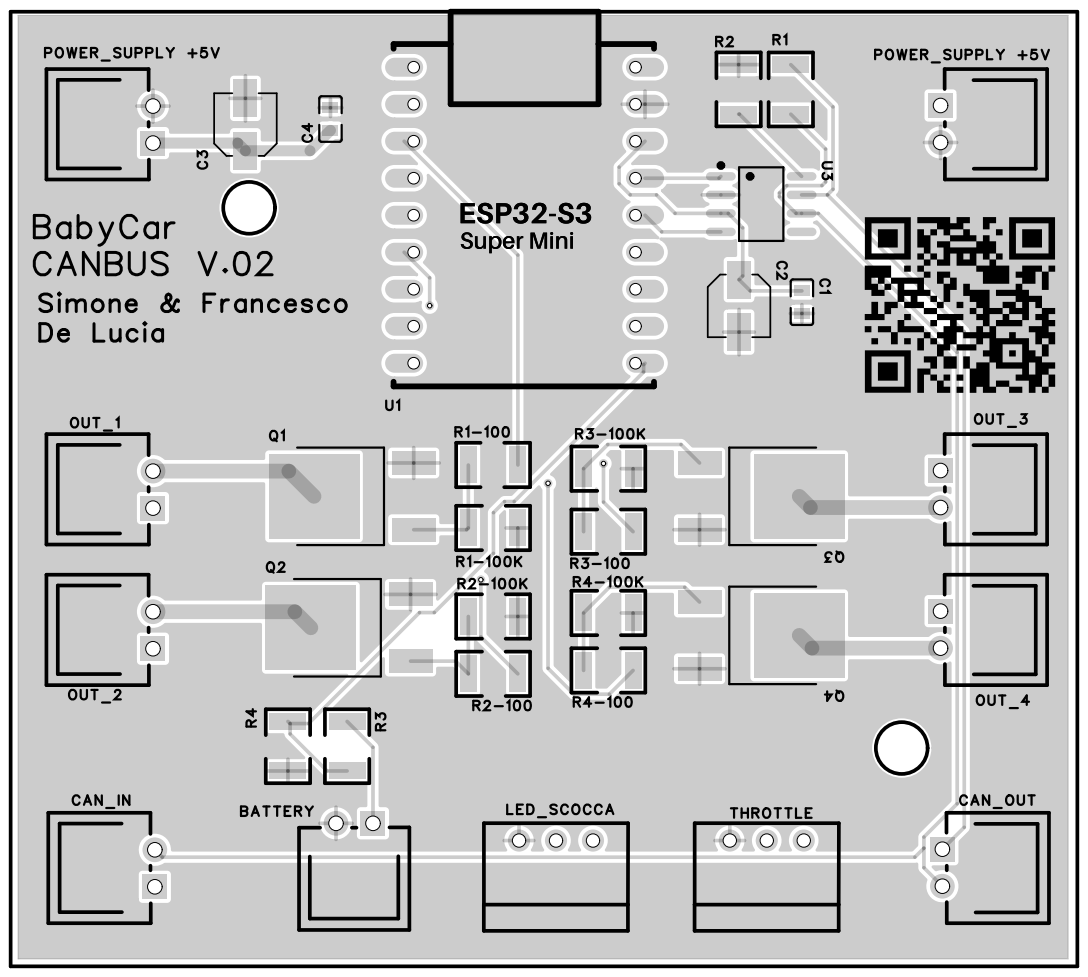
[picture p44: page 5]

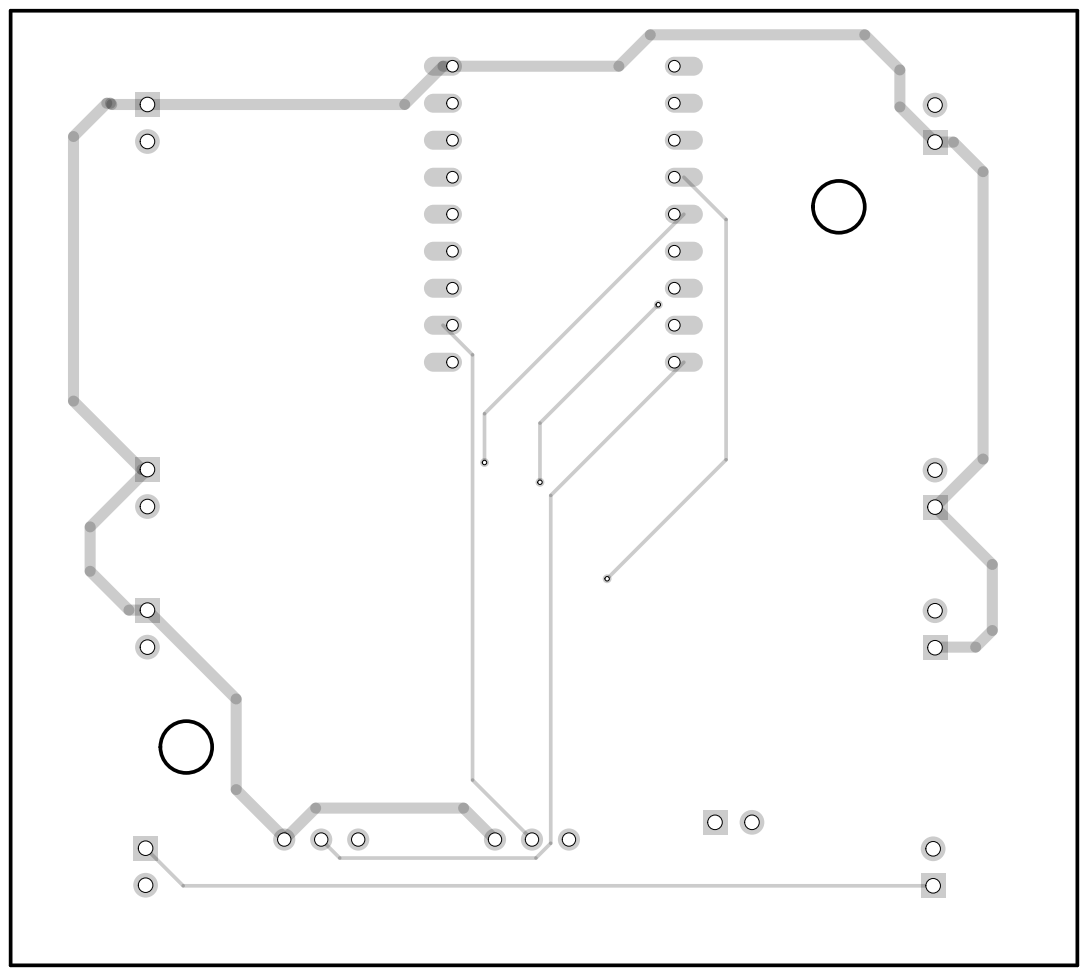
[picture p45: page 6]

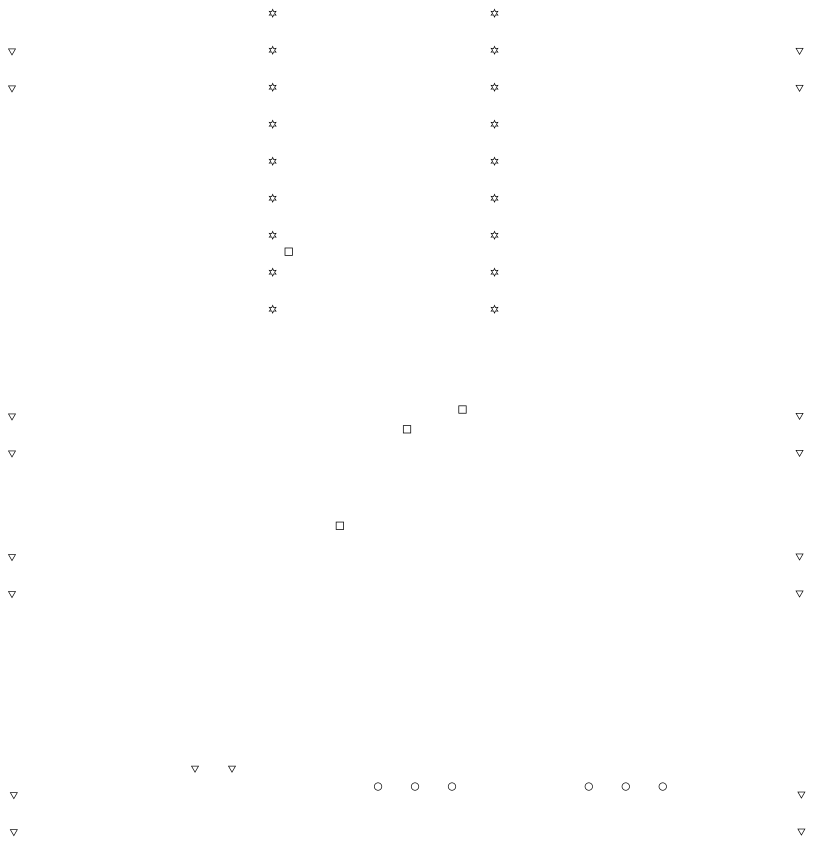
[picture p46: page 7]
