francescodelucia/BabyCarCANBUS/block_diagrams.pdf

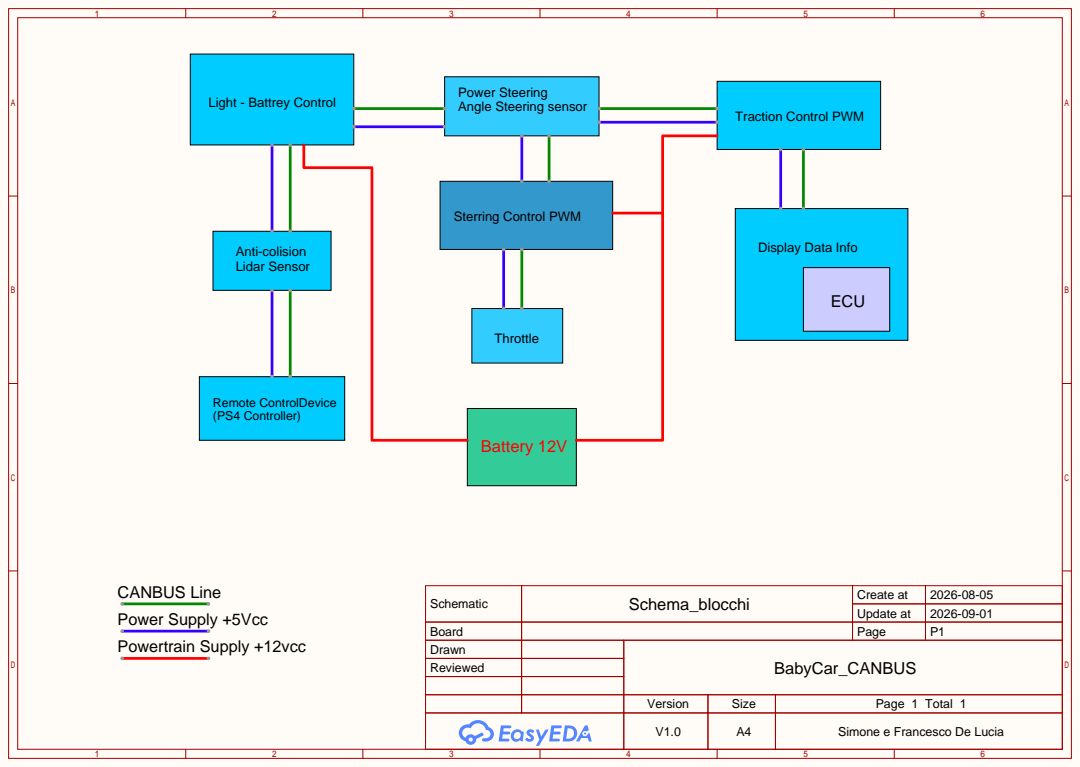
[picture p47: page 1]

Schematic | Schema_blocchi | Create at | 2026-08-05

Update at | 2026-09-01

Board | | Page | P1
Drawn | | BabyCar_CANBUS
Reviewed

Version | Size | Page 1 Total 1
V1.0 | A4 | Simone e Francesco De Lucia
