francescodelucia/BabyCarCANBUS/Componenti_Codice_PCB/CarControllerPS4/SCH_BtPS4Controller_2026-10-22.pdf

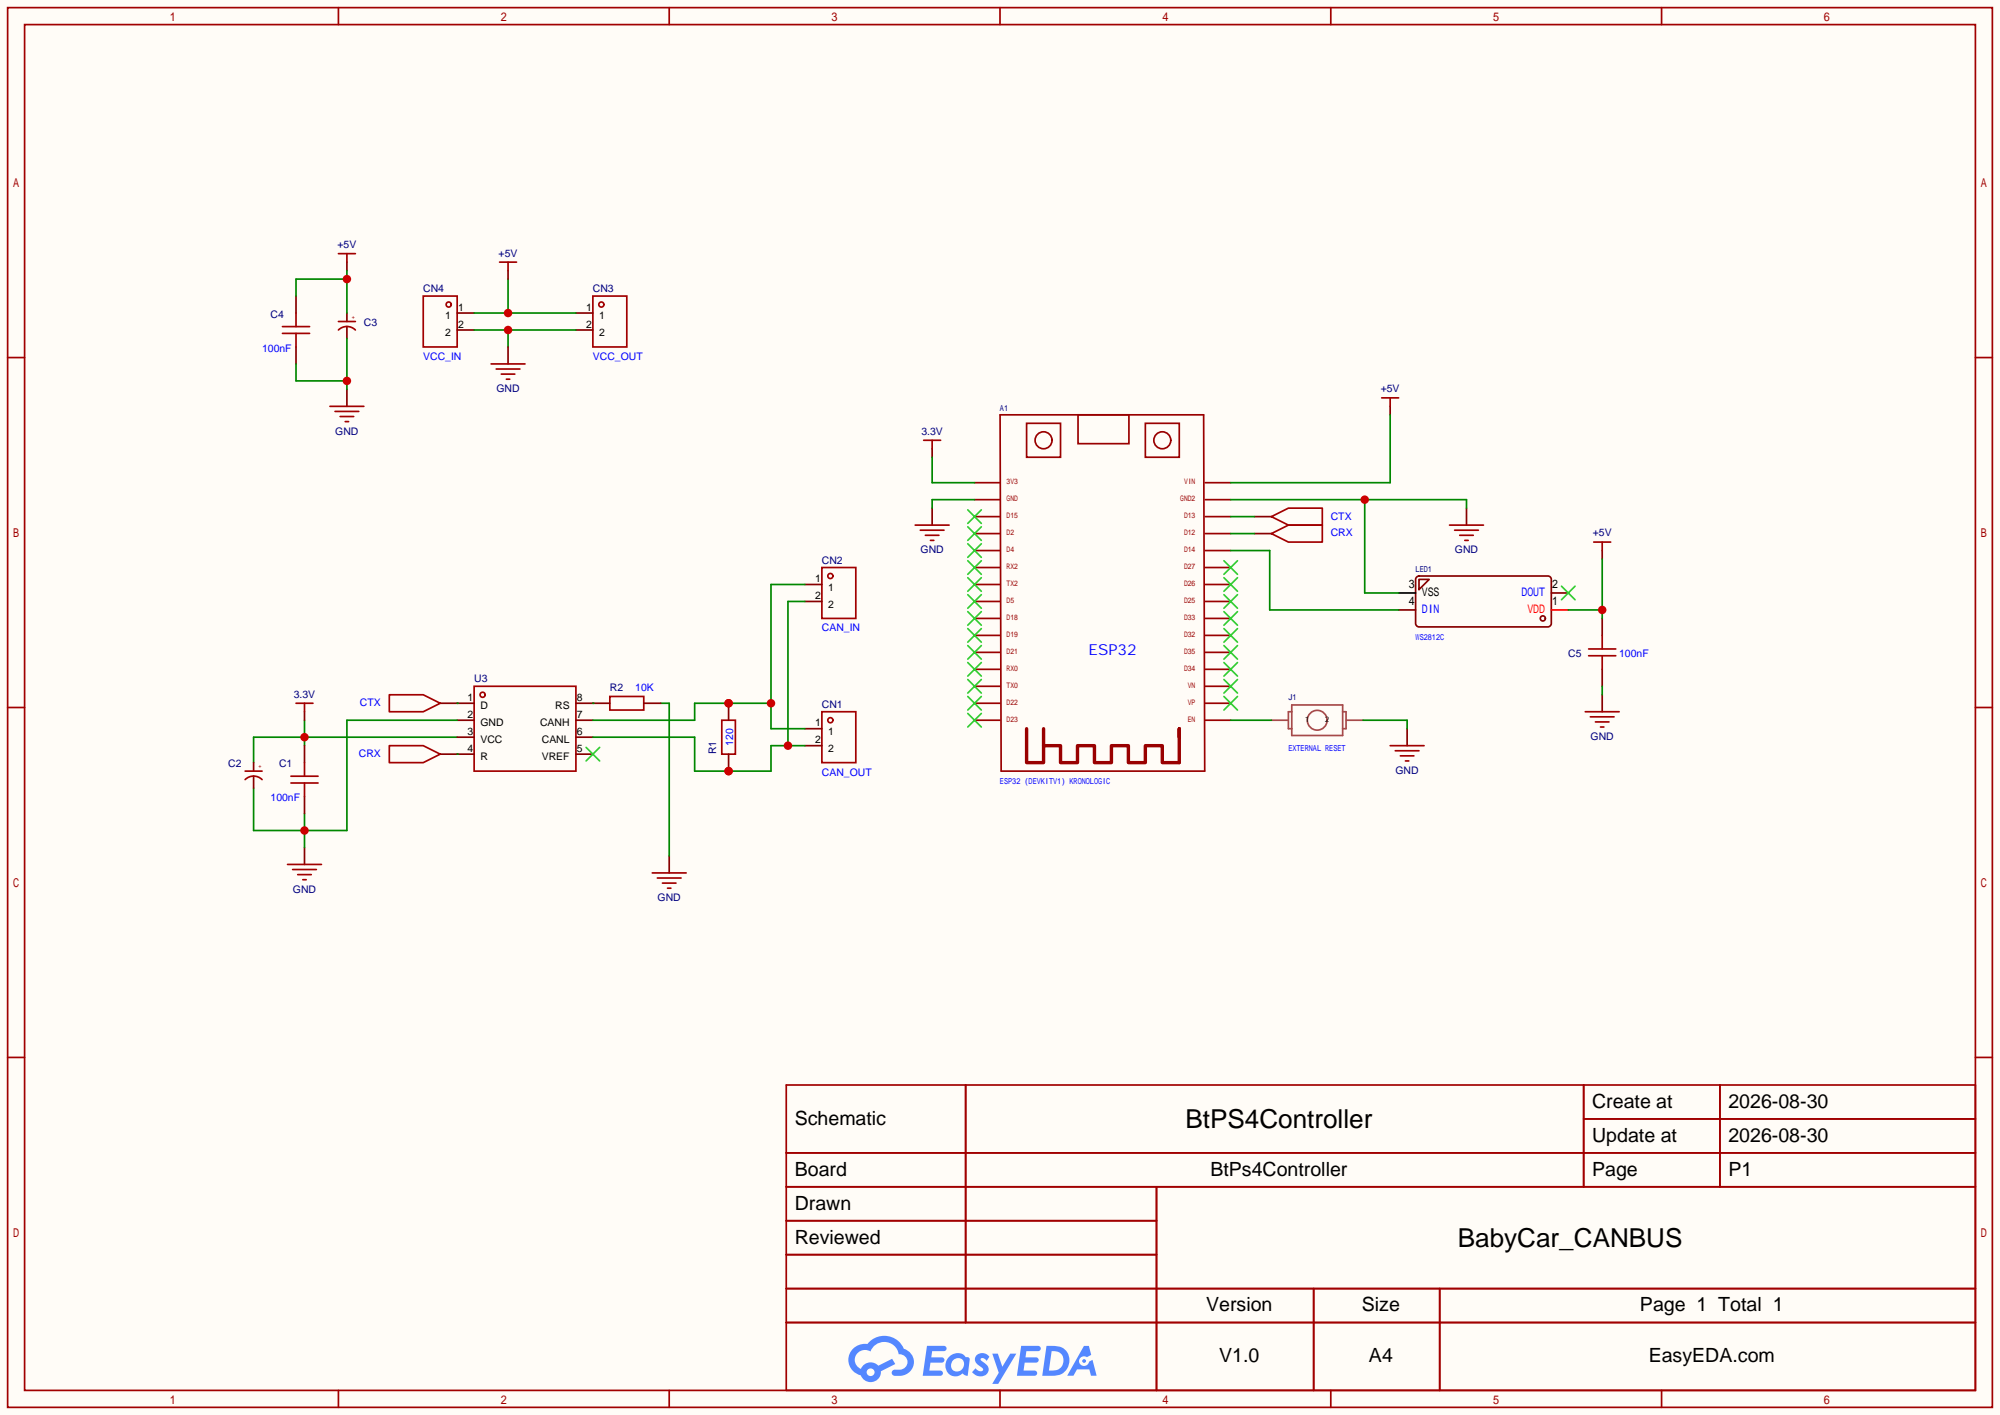
[picture p48: page 1]

Schematic | BtPS4Controller | Create at | 2026-08-30

Update at | 2026-08-30

Board | BtPs4Controller | Page | P1
Drawn | | BabyCar_CANBUS
Reviewed

Version | Size | Page 1 Total 1

V1.0 | A4 | EasyEDA.com
