francescodelucia/BabyCarCANBUS/Componenti_Codice_PCB/Sensore_Lidar/SCH_Anti_Colision_Lidar_2026-10-22.pdf

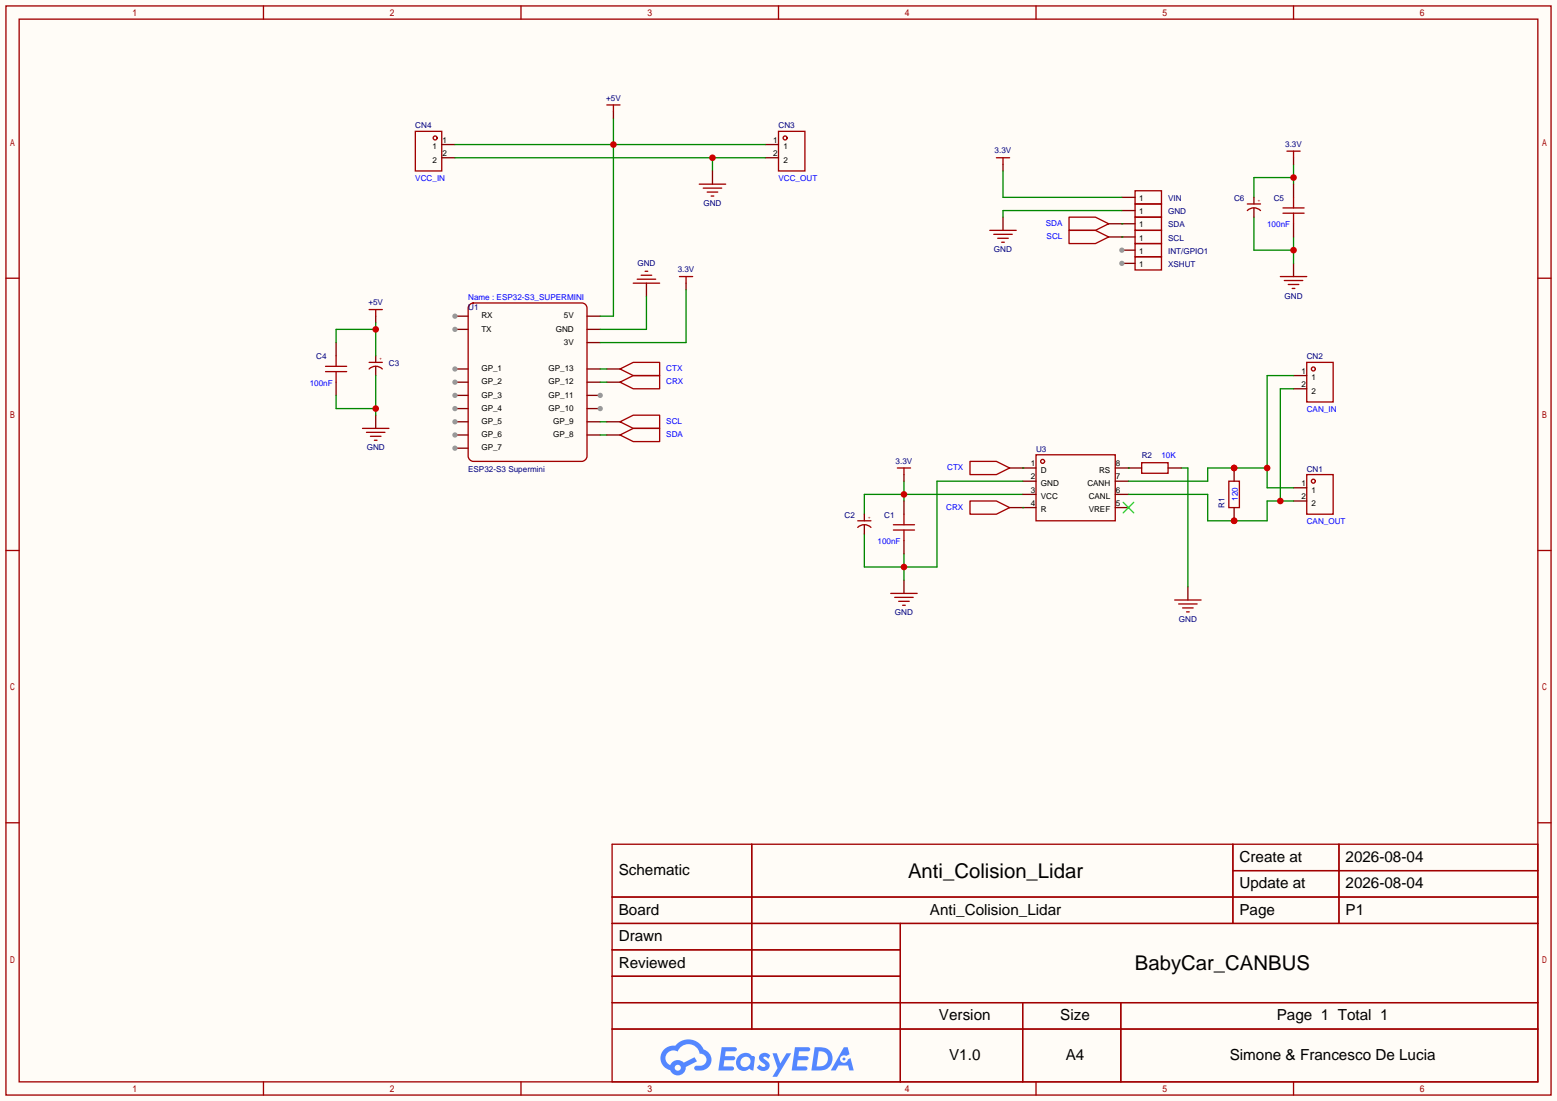
[picture p49: page 1]

Schematic | Anti_Colision_Lidar | Create at | 2026-08-04

Update at | 2026-08-04

Board | Anti_Colision_Lidar | Page | P1
Drawn | | BabyCar_CANBUS
Reviewed

Version | Size | Page 1 Total 1

V1.0 | A4 | Simone & Francesco De Lucia
