francescodelucia/BabyCarCANBUS/Componenti_Codice_PCB/ECU_dashboard_integrato/SCH_Schematic3_2026-10-22.pdf

### CTRL_3

### CTRL_2

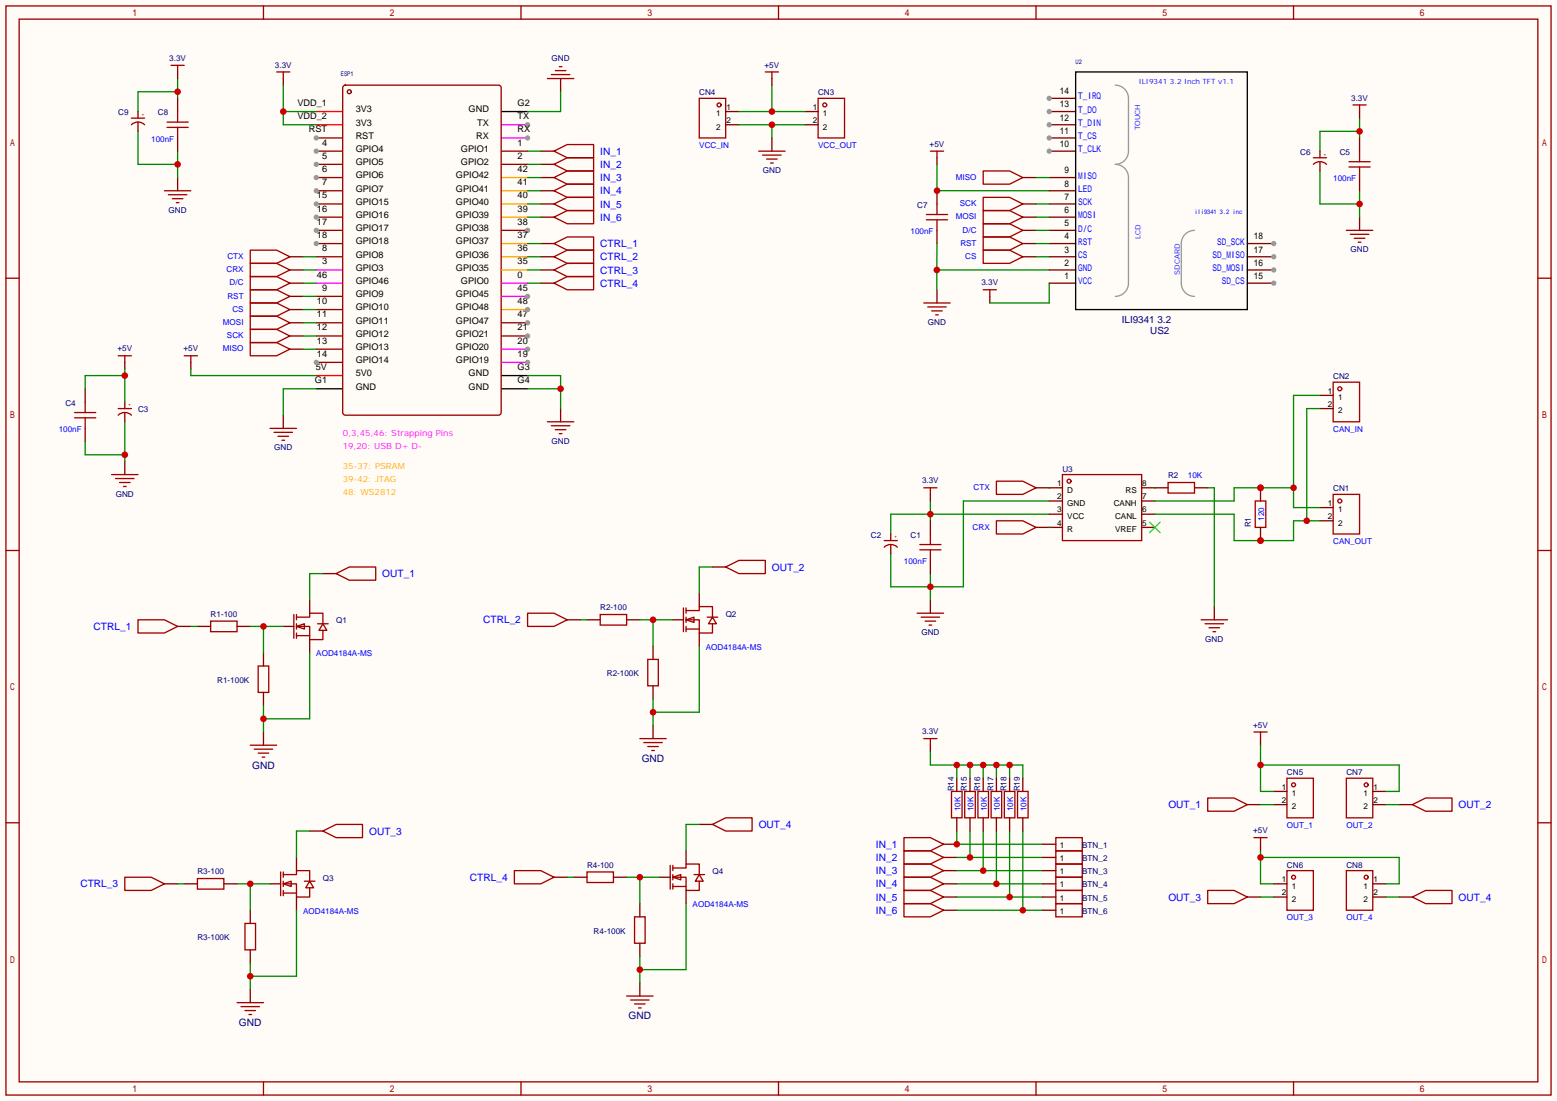
[picture p50: page 1]
