francescodelucia/BabyCarCANBUS/pcbs/ECU_display_data_info/electronic_schema.pdf

# MISOR¹⁵ 10K

# MOSI R¹⁶ 10K

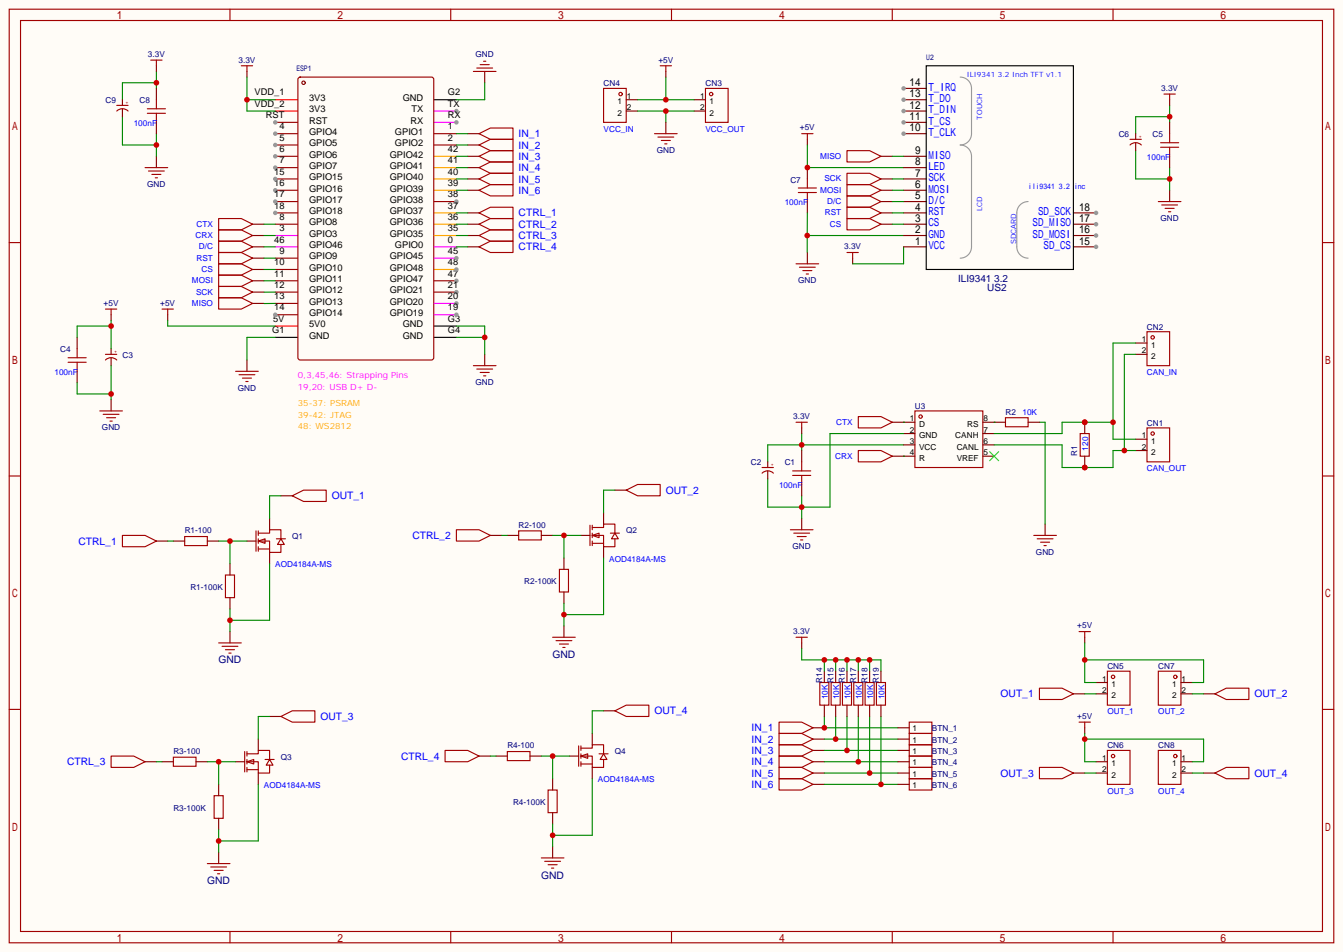
[picture p51: page 1]
